jjsch-dev/filament_dryer_rp2040/README.md

# DIY Dehumidifier for 3D Printer Filaments
This project is a dehumidifier for 3D printer filaments that uses Arduino and Raspberry Pi modules. It heats and dries wet filaments to improve the quality and durability of your prints. It also has some cool features such as:

- A slow temperature ramp that prevents thermal shock and damage to the filaments.
- A heater temperature monitor that protects the equipment from overheating.
- A spool turn counter that tracks how much filament you have used or left.
- A PWM controller that turns on and off the heater based on the spool rotation speed.
- A PWM cut timer that stops the heater after a certain time period for safety reasons.
- A lid sensor that shuts off the heater when you open the lid to access the filaments.
- An auto-tuning algorithm that adjusts the PID constants for optimal temperature control.
- A USB interface that plots the graph of the system response and allows firmware updates.

The project uses a Raspberry Pi Pico instead of an Arduino Nano because it has more RAM and flash memory, which are needed for storing data and running complex algorithms.

I worked on the development of this project alongside with my friend [Manuel](https://www.printables.com/@ManuelM). He made the 3D model design of the enclosure and all its printable components. Plese use the following link [DIY Dehumidifier for 3D Printer Filaments](https://www.printables.com/model/494417-diy-dehumidifier-for-3d-printer-filaments) to get the step and the 3mf files.

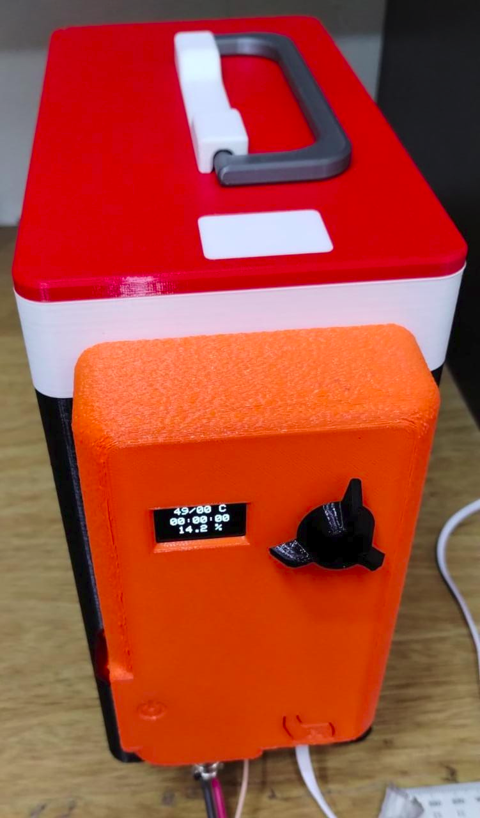
[picture p1: images/prototype-front.png]


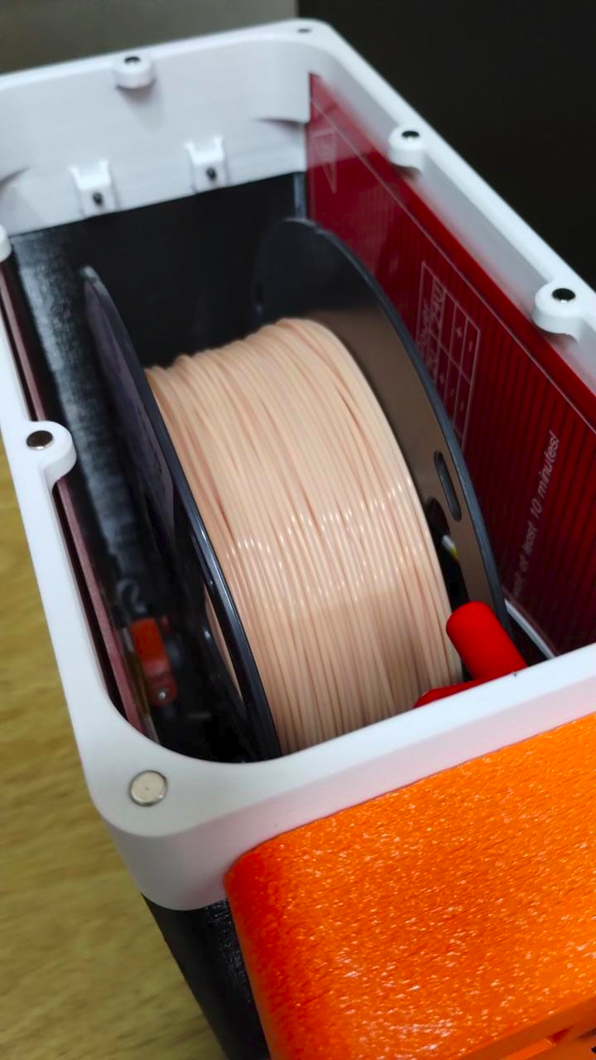
[picture p2: images/prototype-up.png]


Assembly Video
--------------
As the equipment has many parts, an assembly manual in this instance of the project becomes slow to produce, so we decided from Fusion 360 to generate a video where, in addition to seeing the dehumidifier explode, the assembly steps, screws and magnets are shown.

> All the magnets are placed under pressure (the holes have almost no play) and they must also be glued with cyanoacrylate so that the temperature does not loosen them.

> The cap handle and optical sensor bracket screws are parkers, the rest are M2x5 or M3x10/12.

https://user-images.githubusercontent.com/55675185/213236978-26854887-6648-46aa-a964-80c38ac183d2.mp4

Temperature control
-------------------
The temperature control module is based on the [QuickPID](https://github.com/Dlloydev/QuickPID) library which has an advanced anti-windup mode which prevents deep saturation and reduces overshoot.

The task of calculating the PID constants is based on the same author's [sTune](https://github.com/Dlloydev/sTune) library which uses an open-loop PID auto-tuner using a novel s-curve kneepoint test method.

Measurement of the humidity and temperature of the box
------------------------------------------------------
The equipment uses the [SHT21](https://sensirion.com/products/catalog/SHT21/) sensor from Sensirion to measure the humidity and temperature of the box. This sensor can be purchased as a mounted module from [Adafruit](https://www.adafruit.com/product/1899) or other suppliers. To read the data from the sensor, the [HTU21D](https://github.com/devxplained/HTU21D-Sensor-Library) library is used through the I2C port.

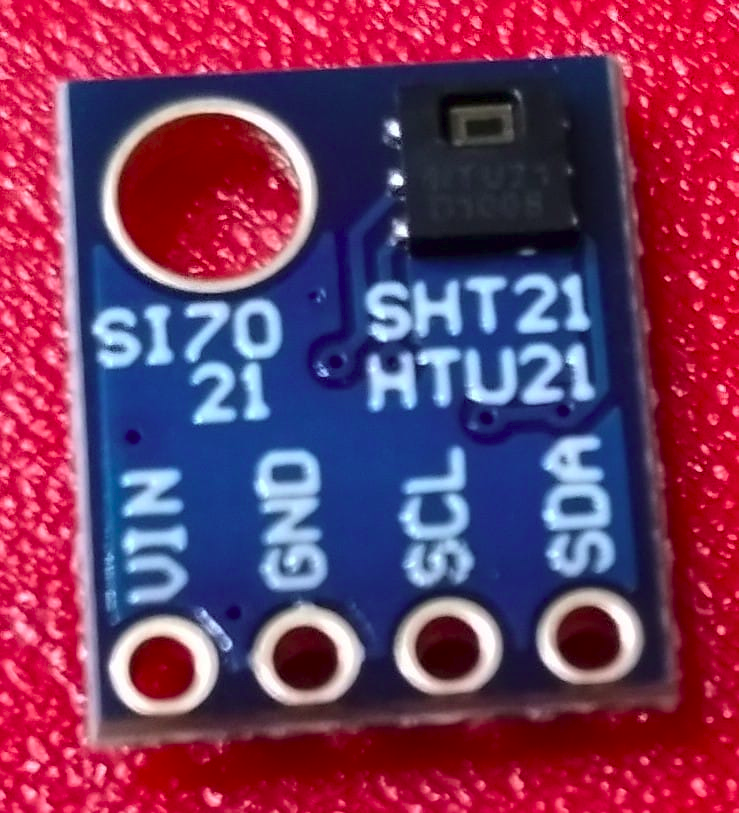
[picture p3: images/temp_humidity_sensor.png]


Thermistors for Over Temperature Protection
-------------------------------------------
The heaters can reach very high temperatures that can damage the system or cause a fire. As the box is printed in Petg a protection system was implemented that turns off the heaters when a temperature above a 80 degrees is detected. The system uses two thermistors of [100 KHOM at 25ºC and a B of 3950K ±1%](https://a.aliexpress.com/_m0eyg30) to measure the temperature of each heater. 
Thermistors are resistive sensors that vary their value according to temperature. However, due to the deviation of the associated hardware (4k7 resistance and reference voltage of the analog-digital converter), it is necessary to calibrate the thermistors to improve their accuracy. The calibration is done using as reference the temperature of the SHT21 sensor that measures the temperature of the thermal box and has an accuracy of 0.5%. The calibration consists of calculating a factor that is applied to the [thermistor](https://github.com/miguel5612/ThermistorLibrary) library readings to correct their value. This factor is stored in the Arduino’s EEPROM memory for use in future measurements. The calibration can be done from the Calib menu on the LCD when temperatures are stabilized.

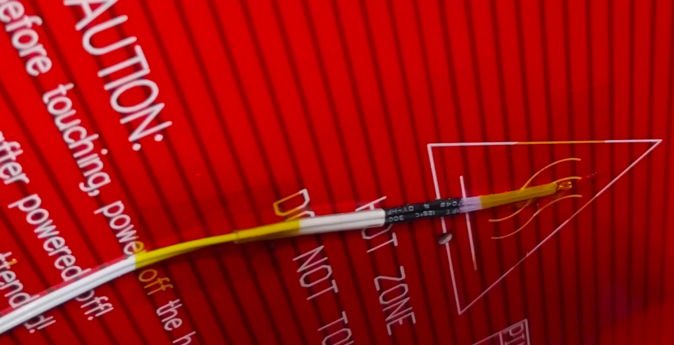
[picture p4: images/thermistor_mounted.png]


Since there is no Arduino module for the thermistors, the divider resistor and filter capacitor are installed on the berry pico board as shown in the picture.

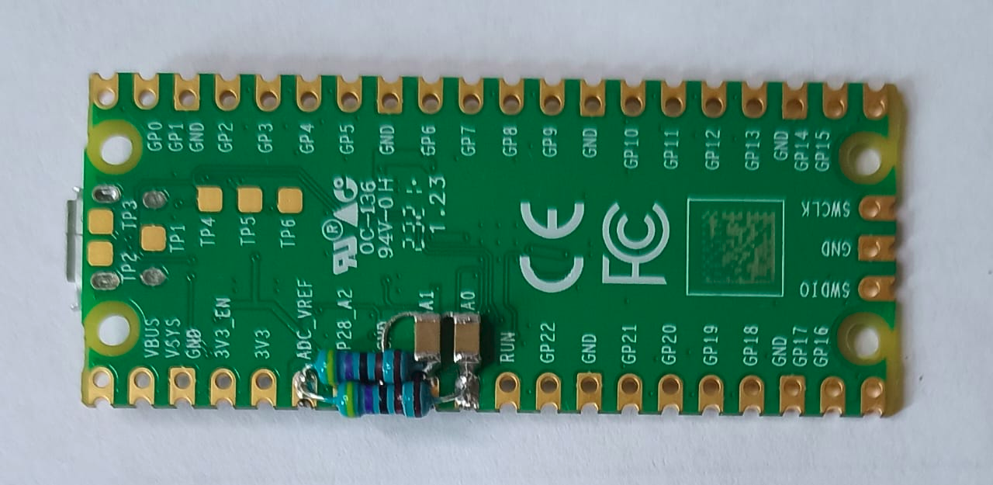
[picture p5: images/thermistor_berry.png]


> Note: For now the thermistor library does not include the pull request that adds compatibility with arduinopico, so use this [link](https://github.com/jjsch-dev/ThermistorLibrary) to download the modified one.

User Interfase
--------------
The user interface is based on a 0.96-inch OLED screen that displays text and uses the [Adafruit_SSD1306](https://github.com/adafruit/Adafruit_SSD1306) library through an I2C interface.

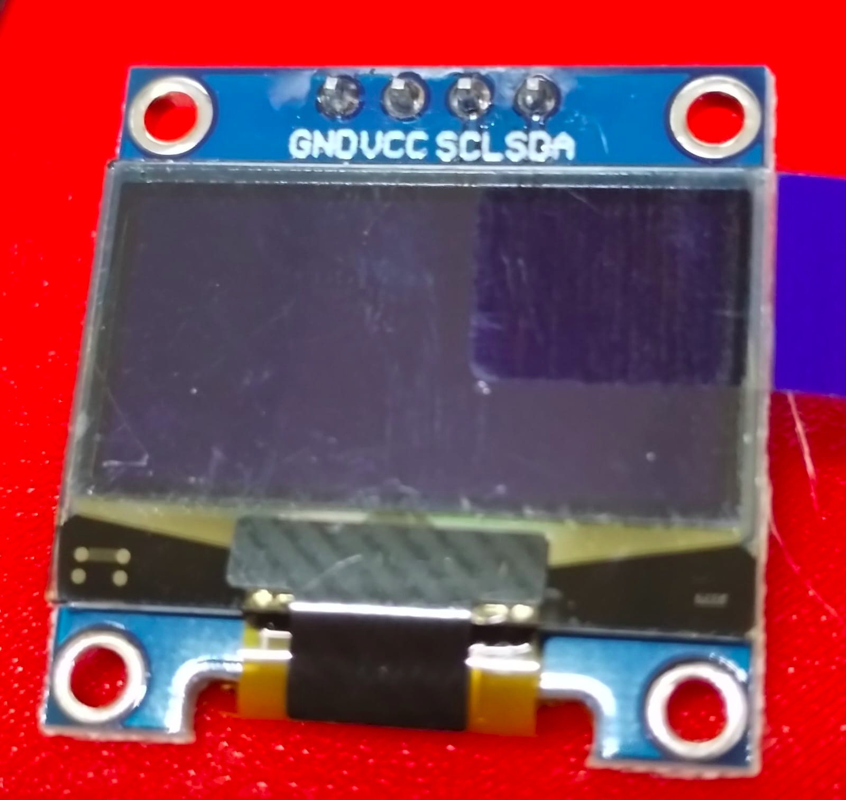
[picture p6: images/oled_display.png]


For user input, we use a rotary encoder and the [EncoderButton](https://github.com/Stutchbury/EncoderButton) library, which depends on the [Encoder Library](https://www.pjrc.com/teensy/td_libs_Encoder.html) and the [EncoderLibrary Bounce2](https://github.com/thomasfredericks/Bounce2) libraries.

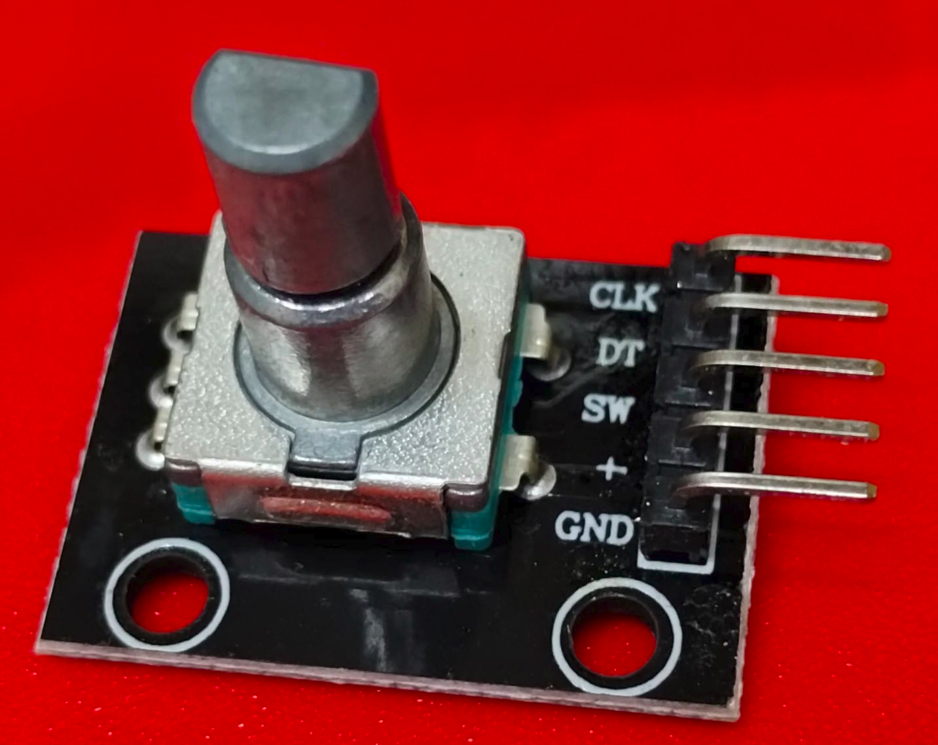
[picture p7: images/rotary_encoder.png]


> Note: For now the Encoder library does not include the pull request that adds compatibility with arduinopico, so use this [link](https://github.com/jjsch-dev/Encoder) to download the modified one.

Heater
------
To heat the box, two 3D printer beds are used as heating elements.

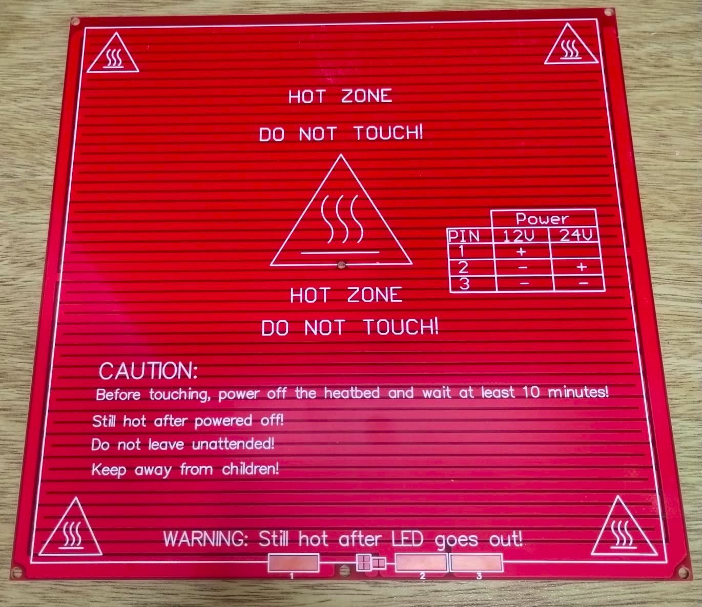
[picture p8: images/heat_bed.png]


And two [15A mofsets](https://a.aliexpress.com/_mNwI6G6) that regulate the power with PWM channels.

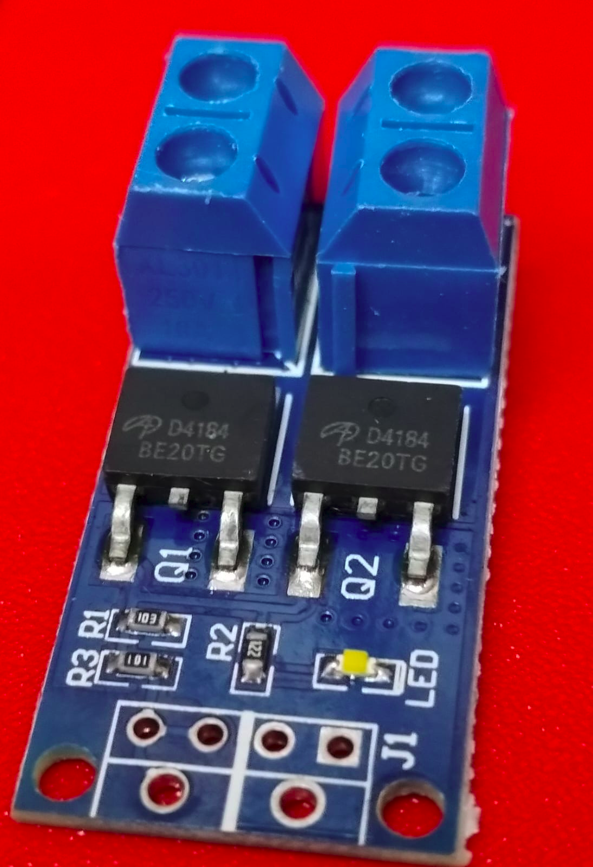
[picture p9: images/mosfet.png]


To homogenize the environment of the box, a [4010 fan cooler](https://a.aliexpress.com/_ms9WyQe) is used that for now turns on at 100%.

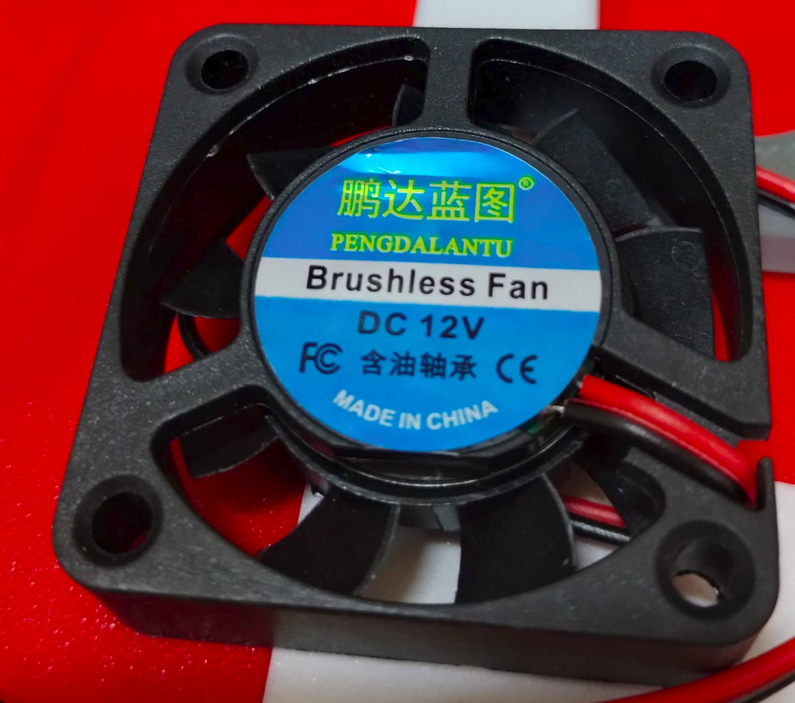
[picture p10: images/fan_cooler.png]


Moisture Ventilation
--------------------
So that the moisture from the filament that evaporates when heating the box goes outside, a ventilation valve is incorporated that is activated by an [Servo SG92](https://www.adafruit.com/product/169).

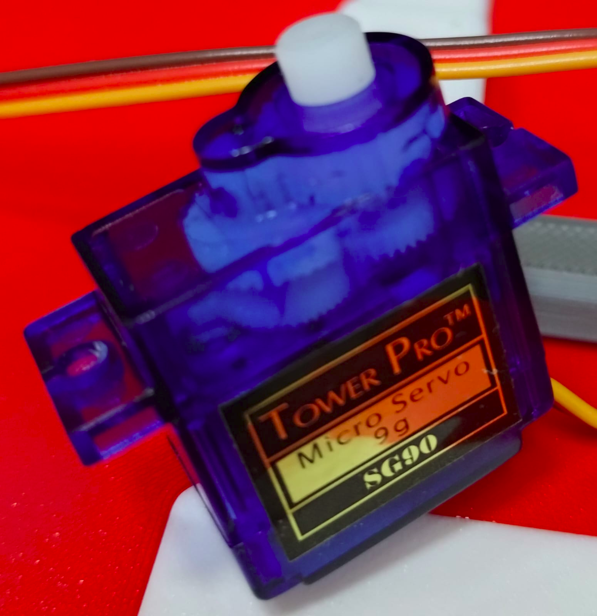
[picture p11: images/servo.png]


To control it, the internal [Servo](https://github.com/earlephilhower/arduino-pico/tree/master/libraries/Servo) library of the arduinopico porting is used, which is based on the PIO of the Rasperry Pi Pico RP2040.

- The valve is made up of three parts: a rectangular hole in the box cover with a 45-degree chamfer to increase the contact surface, the valve that has a 0.2 mm offset, and a post that, in addition to being the stop, supports the magnet that brings the door to the closed position. To fasten it, two M2 * 5 screws are used.

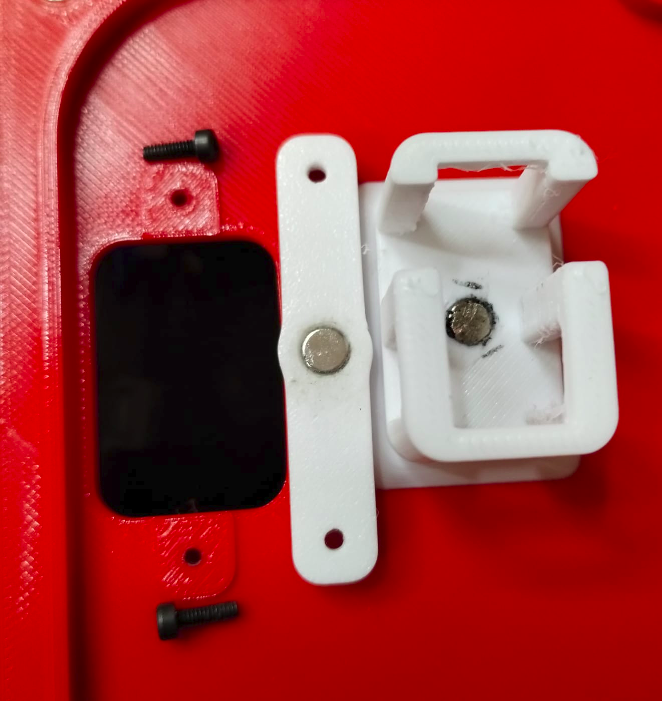
[picture p12: images/valve_parts.png]


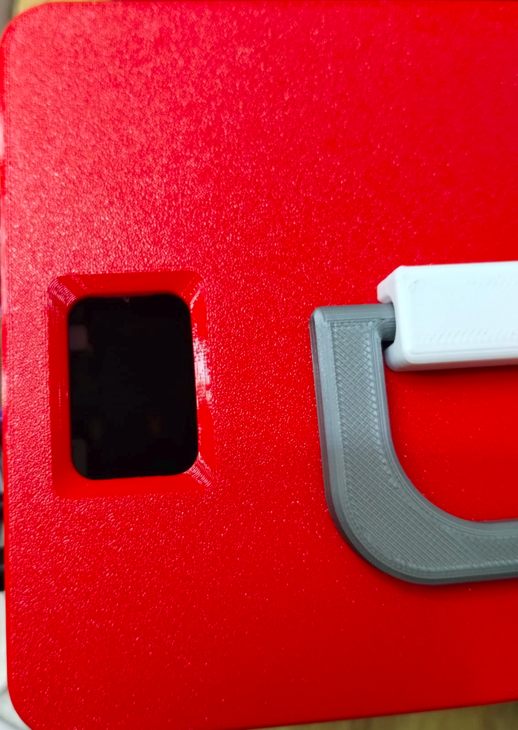
[picture p13: images/valve_cap.png]


- When the servo arm moves down and stops pushing on the valve, the magnets attract each other and create a force of approximately 300 grams to close the vent.

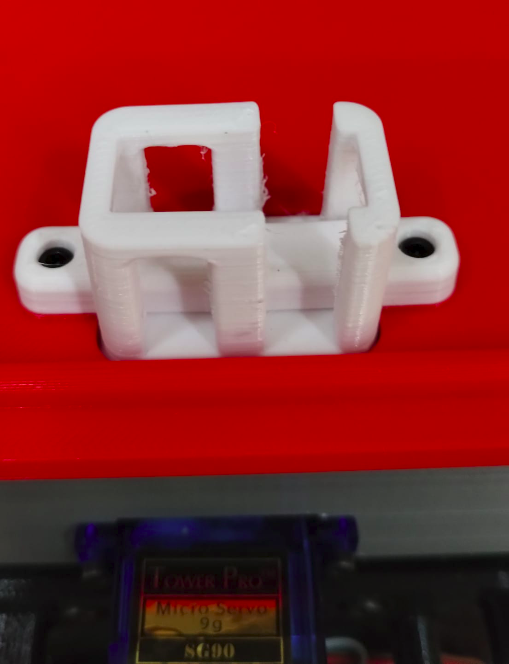
[picture p14: images/valve_close.png]


- To open the valve, the servo moves the arm approximately 45 degrees, it should be noted that the servo makes the most effort at the beginning, and the plastic gear version can make a torque of 1.5 kg per centimeter.

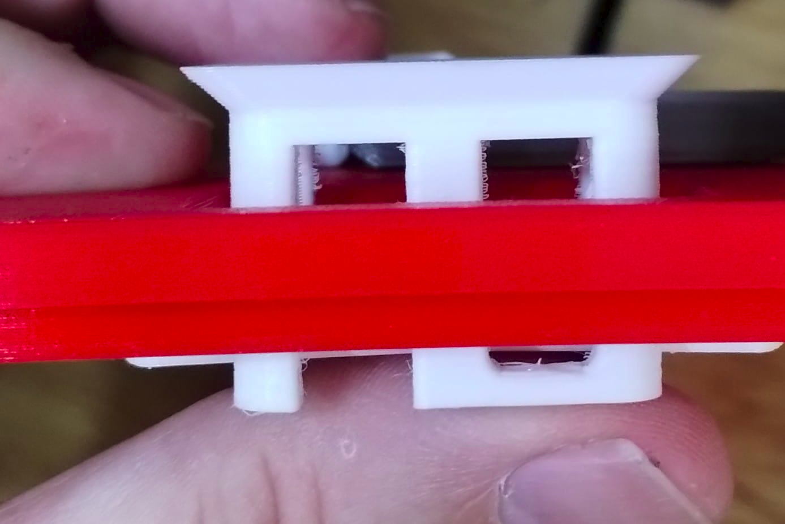
[picture p15: images/valve_open.png]


- The servo arm is a combined part between 3D printing and injection that is sold with the kit. This is because in addition to the fact that the shaft rack is difficult to print, heat easily warps common printed plastics.

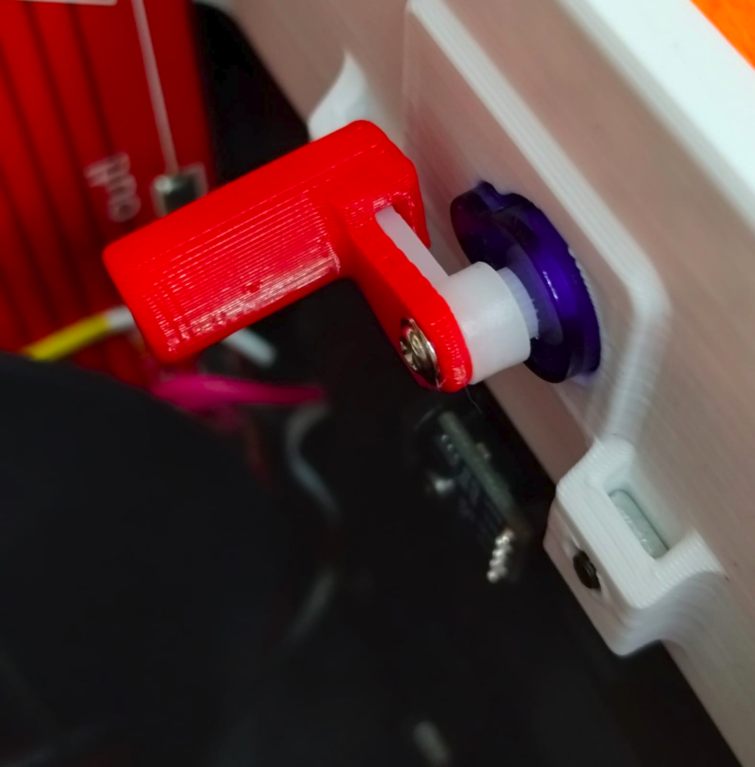
[picture p16: images/valve_servo.png]


Door lid sensor
---------------
The door lid sensor is a mechanical switch with an anti-bounce circuit that detects if the lid of the heater is open or closed. The switch is connected to GP22 of the digital pins of the Arduino board and reads either HIGH or LOW depending on the state of the lid.

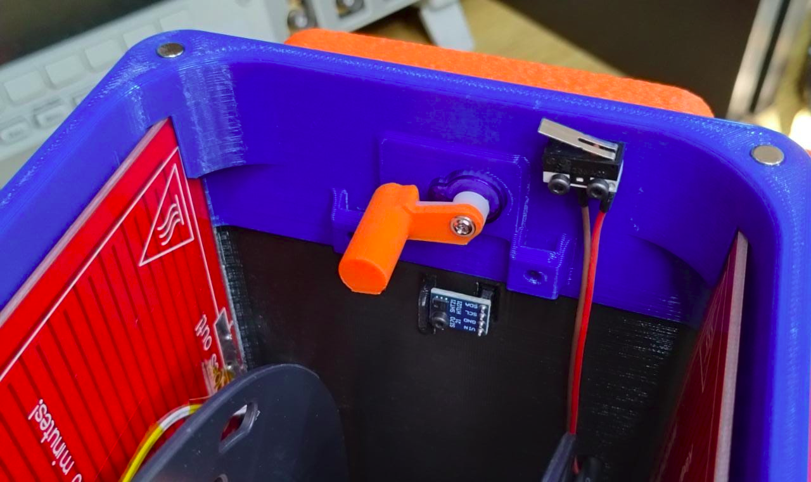
[picture p17: images/door_lid_sensor.png]


If the lid is open, the Arduino displays a message on the LCD screen saying “Open Lid” and turns off the heater by setting the output pin of the mofset to LOW. This prevents overheating and potential fire hazards.

If the lid is closed, the Arduino waits for a signal from the operator or the start system that detects the reel’s rotation to resume operation and control the heater using a PID algorithm based on the readings from the temperature and humidity sensor.

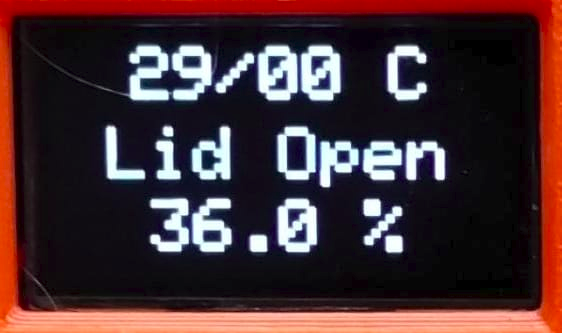
[picture p18: images/door_lid_open.png]


Install the arm on the servo
----------------------------

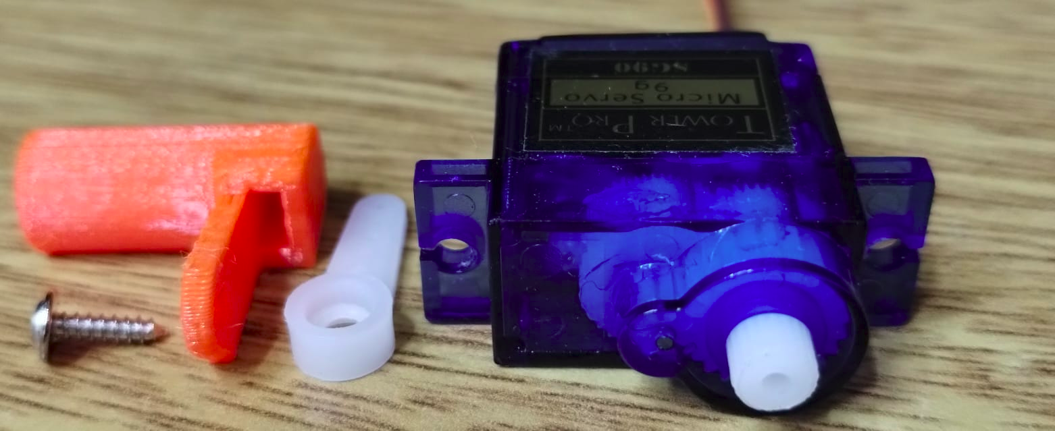
[picture p19: images/arm_servo_parts.png]


- Once the electronics of the equipment have been assembled and the firmware downloaded, connect it to the USB and select turn off the equipment in the menu so that the servo turns to the closed position.

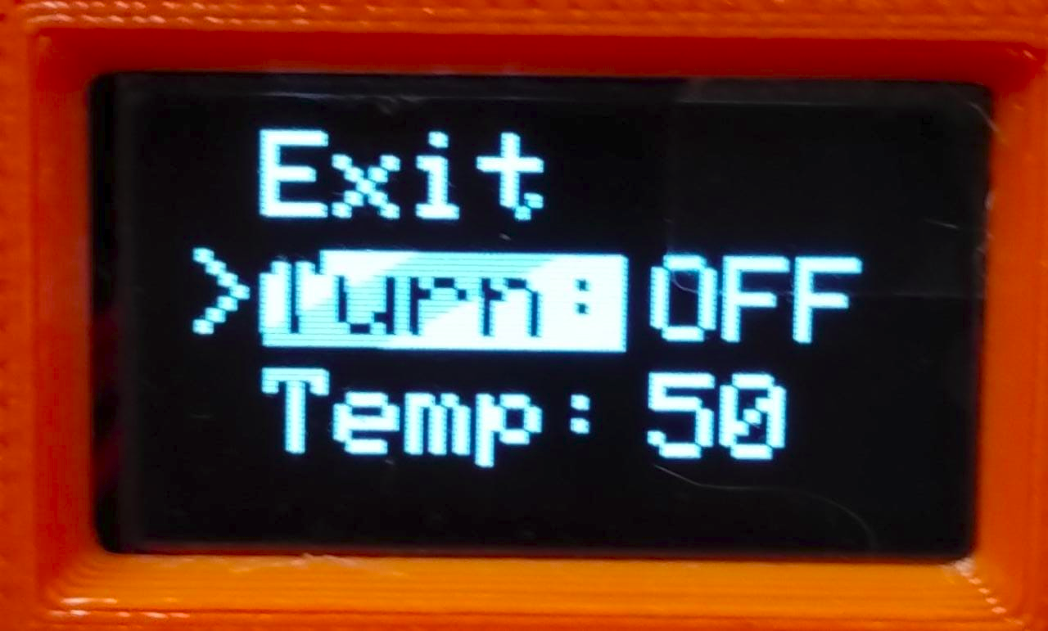
[picture p20: images/arm_servo_off.png]


- Insert the lever that comes with the servo kit more or less at 95° with respect to the vertical of the drawer as shown in the figure. 

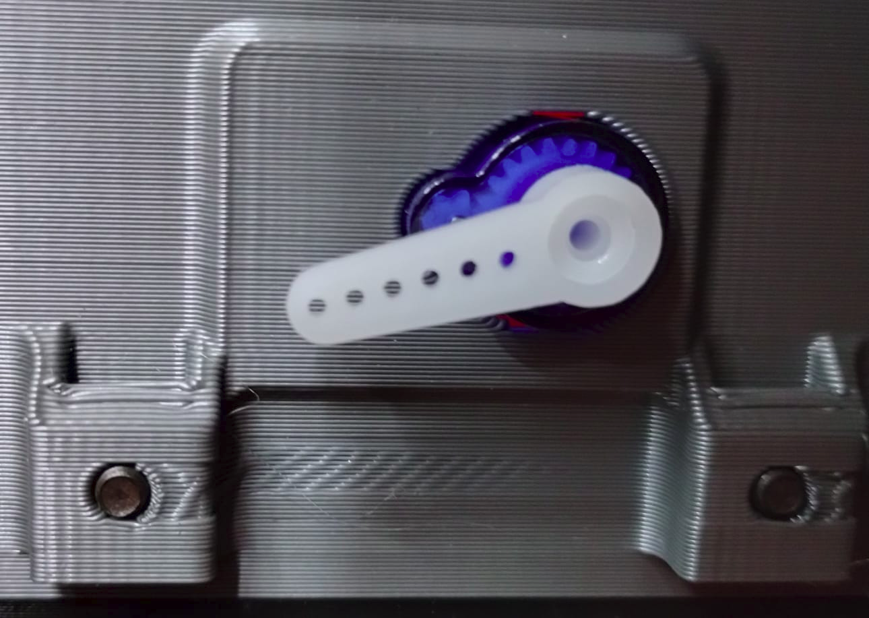
[picture p21: images/arm_servo_abs.png]


- Insert the PETG printed lever and use the long screw that comes with the kit to attach the parts to the servo shaft.

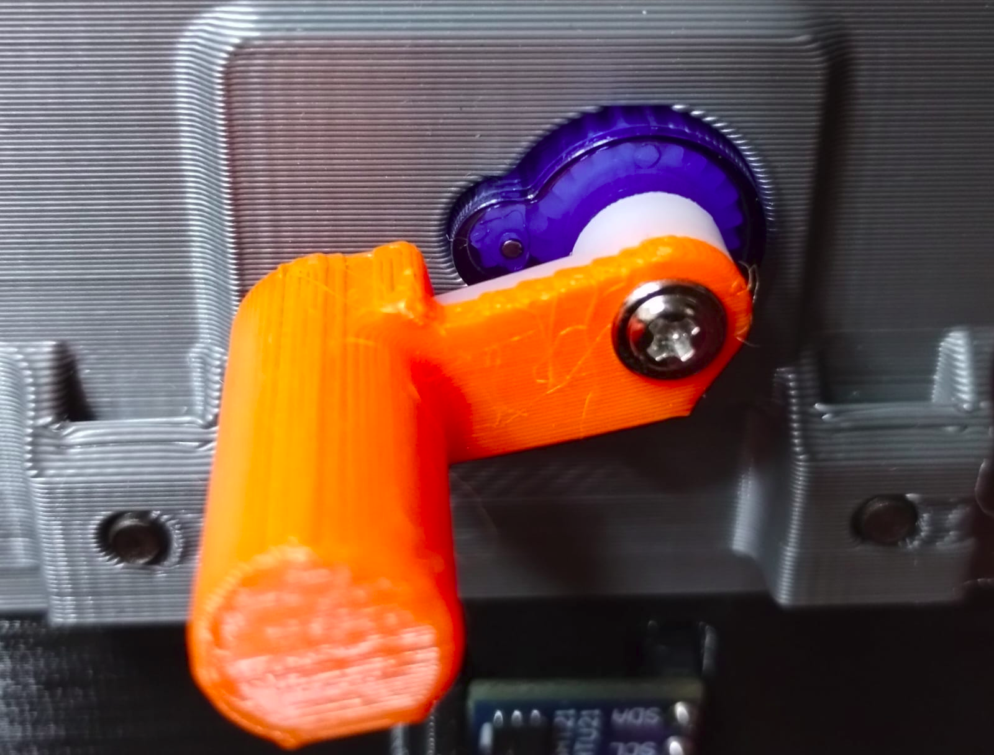
[picture p22: images/arm_servo_close.png]


- Go to the menu and turn on the equipment.

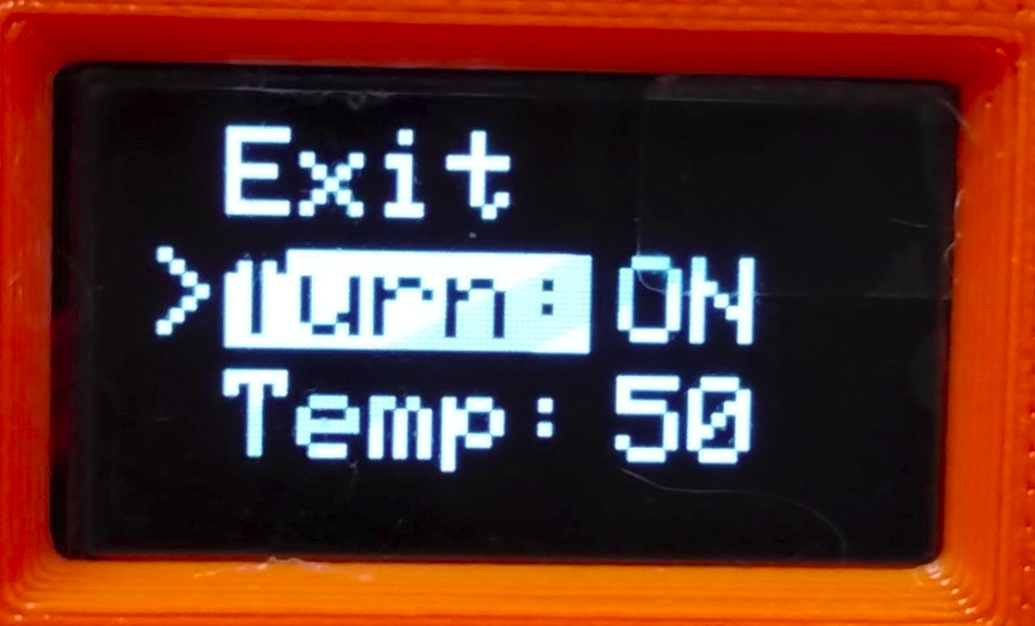
[picture p23: images/arm_servo_on.png]


- The arm should go up as the image shows.

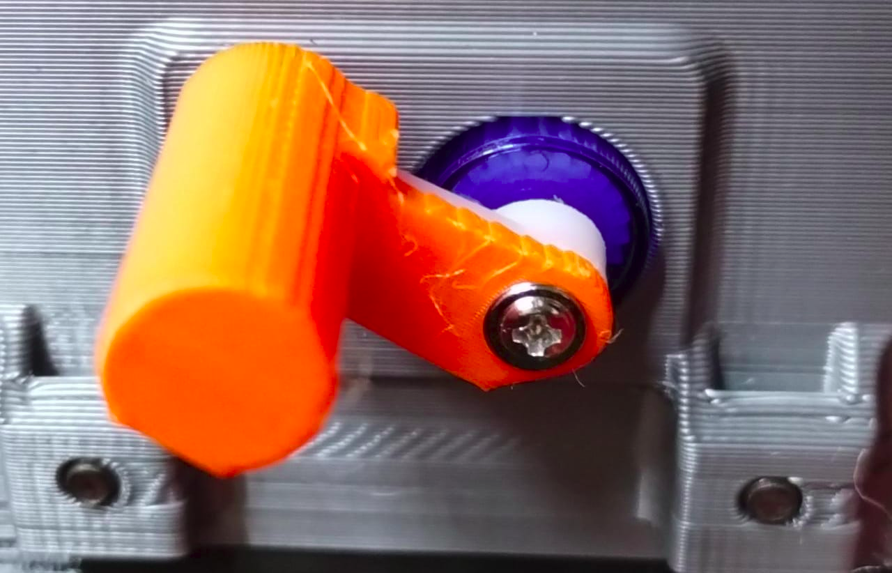
[picture p24: images/arm_servo_open.png]


- To adjust the positions use the menu (close/open) to modify the opening and closing angles, pay special attention that in the **open** position the valve has play and does not touch the magnet post, and in the **close** position it does not touch the valve so the servo doesn't jam hard and get hot. 

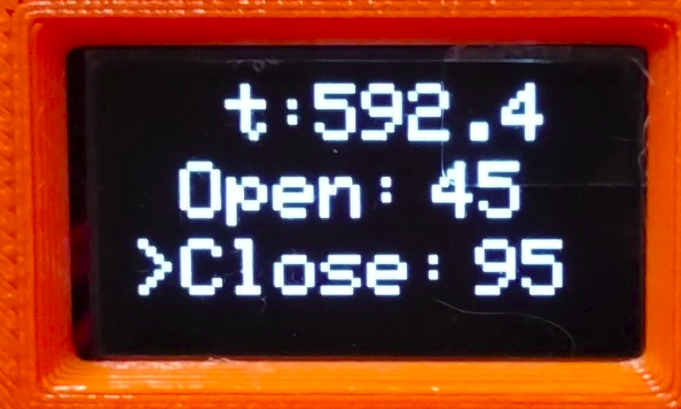
[picture p25: images/arm_servo_adjust.png]


Odometer
--------
One of the axes where the filament spool rests has a 6-position encoder so that an optical [Sensor TCRT5000 Infrared Reflection](https://www.aliexpress.com/i/1005004306354385.html) detects its movement.

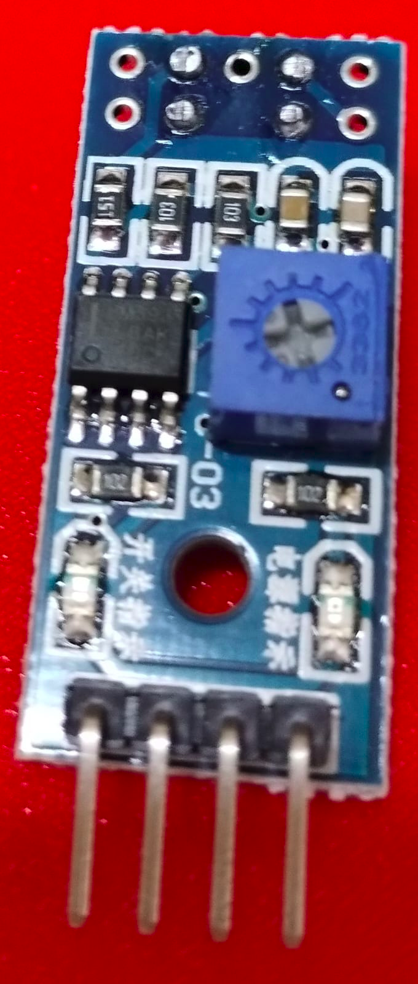
[picture p26: images/optical_sensor_back.png]


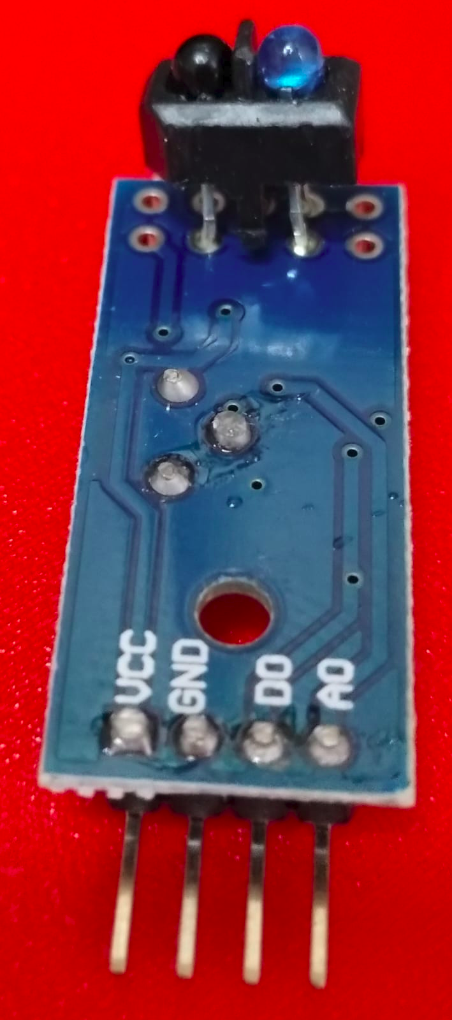
[picture p27: images/optical_sensor_front.png]


One of the functions is to turn on the equipment when it detects that the reel has started to rotate and also to turn off the equipment when it no longer rotates in a certain time.

It also counts the number of turns that the spool has given since the last reset, transforming the pulses into turns by setting the diameter of the spool.

Spool rollers
-------------
The rollers where the spool rests are made up of two parts: a threaded bar M8 * 95mm that gives resistance to deformation by temperature and an ABS cover that positions them. In order for the spool to rotate as smoothly as possible, the axis is supported by two 608 ZZ bearings.

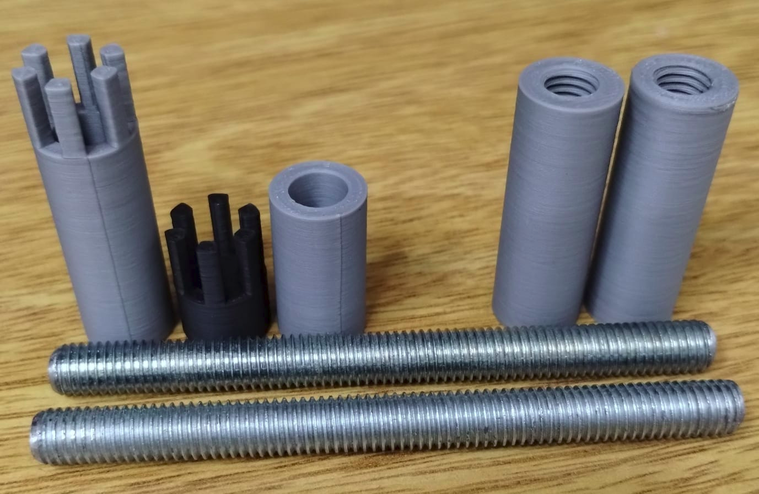
[picture p28: images/spool_rollers_parts.png]


The two ABS covers are different: the used for the optical encoder has three parts, two of a light color (silver or white) and one in black so that the contrast is as high as possible. The second cover is formed by two equal pieces and the color is indistinct.

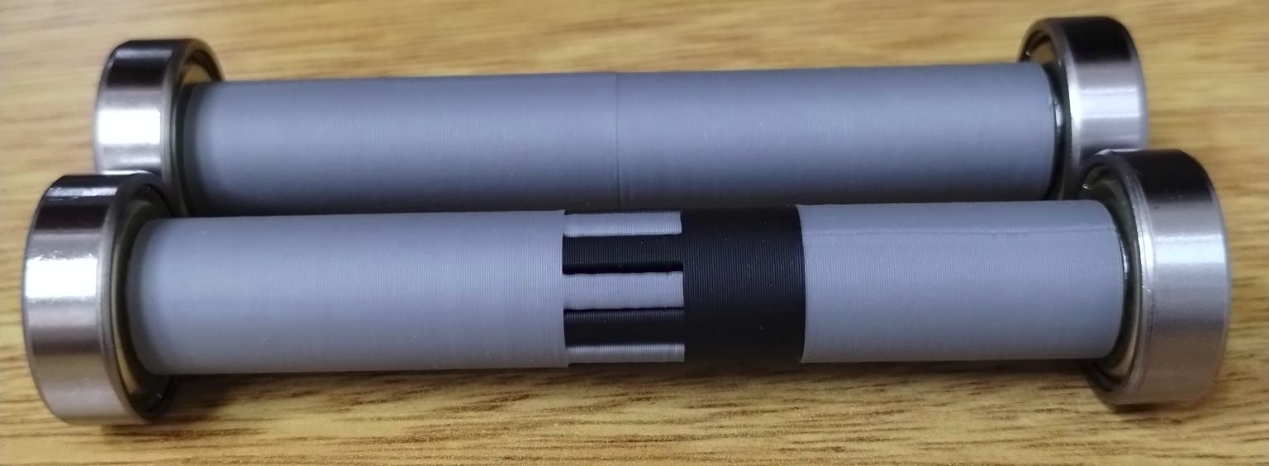
[picture p29: images/spool_rollers_assembly.png]


>The ABS covers are threaded so that they are taut when adjusted.

Odometer sensitivity adjustment
-------------------------------
In order for the TTL output (D0) of the odometer sensor to change when the roller is moved (from white to black and vice versa), the comparator sensitivity must be adjusted with the potentiometer.

- Use an allen key to unscrew the cap on the back of the box and insert a screwdriver until it contacts the potentiometer.

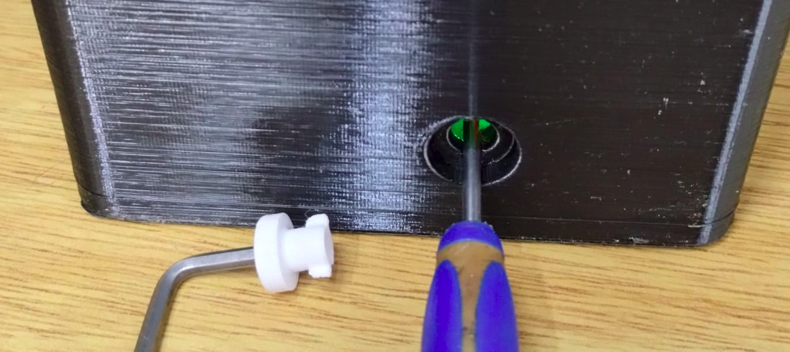
[picture p30: images/unscrew_odometer_cap.png]


- Turn the potentiometer until the sensor status indicator turns off.

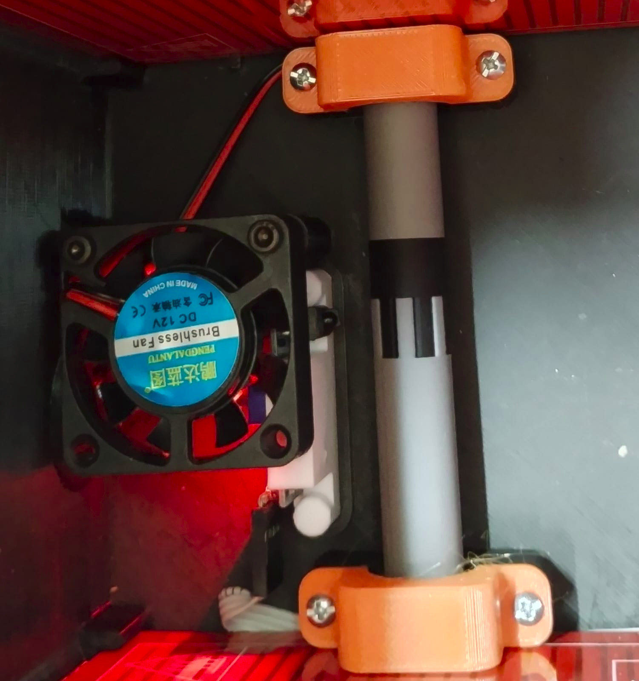
[picture p31: images/odometer_sensor_off.png]


- Rotate the roller by hand until it turns back on, repeat this operation until you are sure the sensor detects transitions from white to black.

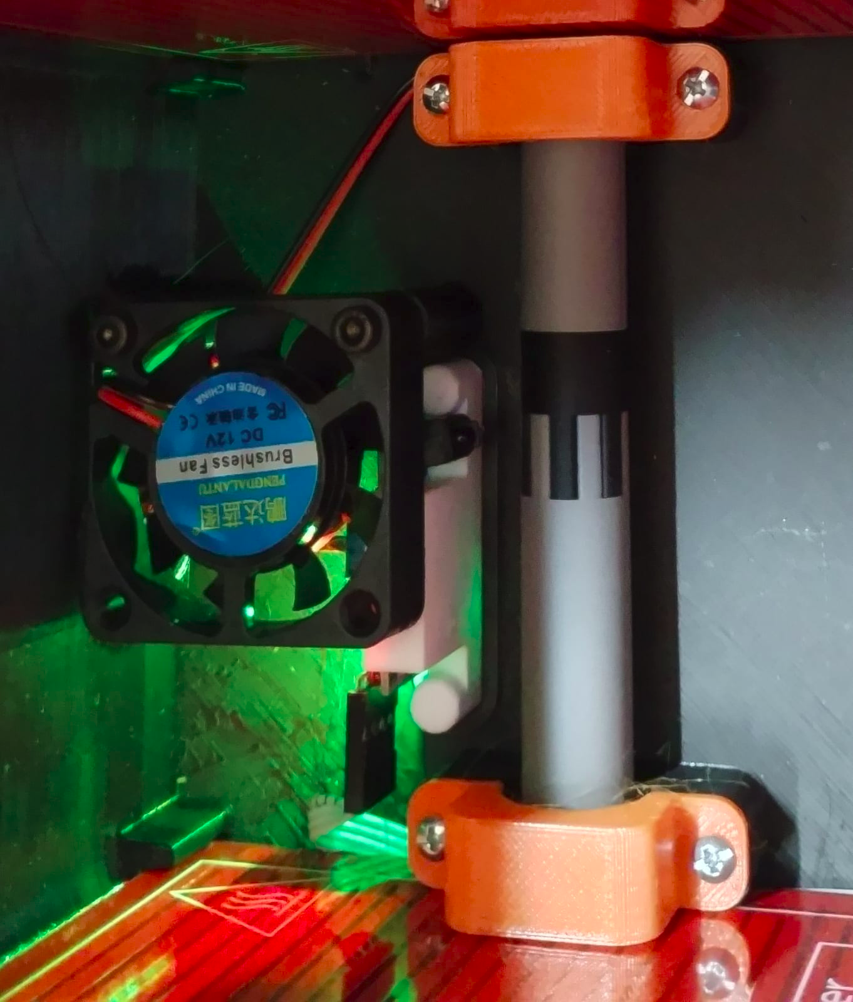
[picture p32: images/odometer_sensor_on.png]


Go to the setup menu to verify that the turns counter (t) increases as the reel rotates.

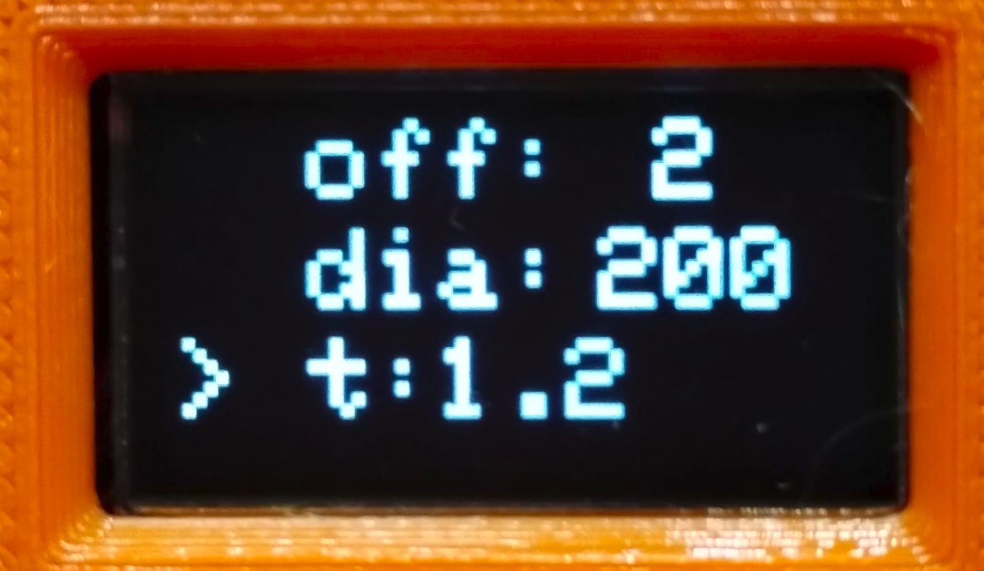
[picture p33: images/odometer_turns.png]


Menu
----
The configuration menu maintains a simplified operation from the time when the Arduino Nano was used, which has little RAM and FLASH memory, this is not the case with the Berry.

When the device is in information mode, it displays three lines of data. 

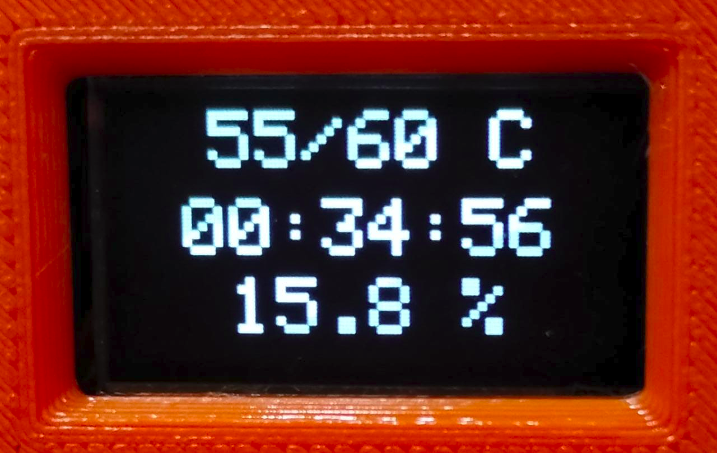
[picture p34: images/display_info.png]


- The first on the left shows the current temperature of the box and on the right the set one (0 = device off).
- The second line shows the remaining operating time.
- The third is the relative humidity of the box.

To enter the configuration menu you have to press the encoder.

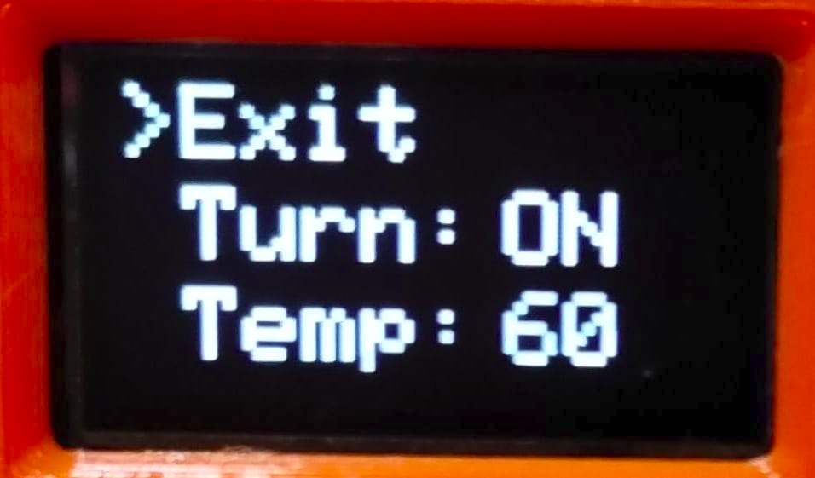
[picture p35: images/display_enter_cfg.png]


Using the rotary encoder you can explore all the menu items, and when you need to modify a value, you have to press the encoder button, if it is editable the item is marked by inverting the colors.

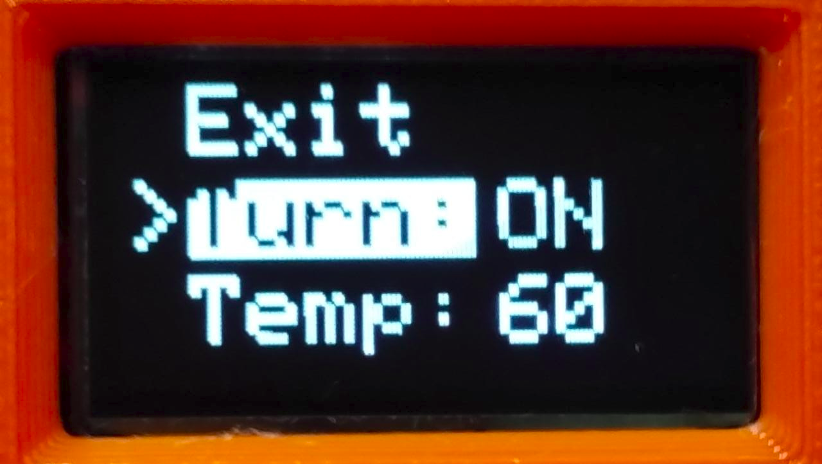
[picture p36: images/display_item_edit.png]


Use the rotary encoder to modify the value of the element, which can be numeric or a list of options. When the rotary encoder button is pressed, in addition to saving the value in the eeprom memory, editing ends.

## Menu List
- **Exit** press the button to exit the menu.
- **Turn** turns the temperature control on/off. 
- **Temp** select the temperature of the box, the range is from 40 to 60 ° Celcius. 0 = disabled.
- **Time** select temperature control run time in hours, range is from 1 to 72 hours. 0 = disabled.
- **Tune** On to allow the device to calculate the PID constants and save them to the eeprom. It is advisable to do it with a full spool and starting from room temperature.
- **Therm**  select the number of thermistors that sense the temperature of the heater to prevent it from melting the bed supports (80°Celsius). At least one is recommended.
  - **cali** calibrate the thermistors to improve their accuracy. It is important to calibrate them when temperatures are stabilized (12 hs OFF) to get better results. 
- **Heat** displays the temperature of the heating element. Use the thermistor that is hotter.
- **Odom** activates the functions of turning on (Start) the heating element when the reel rotates, or turning off (Stop) when it has stopped for a while. (Both) activates both functions.
  - **off** time in minutes that it waits to turn off the heater when the spool stops spinning. 
  - **dia** diameter in millimeters of the spool to convert pulses to turns.
  - **t** number of turns that the reel has given since the last reset of the counter. Move the encoder to the left to reset it.
- **Open** position in degrees of the servo when the vent door is open. Typically 90 degrees.
- **Close** position in degrees of the servo when the vent door is closed. Typically 43 degrees.
- **Kp** proportional constant of the PID controller.
- **Ki** integrative constant of the PID controller.
- **Kd** derivative constant of the PID controller.
- **Frst** On to restore all parameters to factory.
- **V** firmware version. 

Schematic
---------
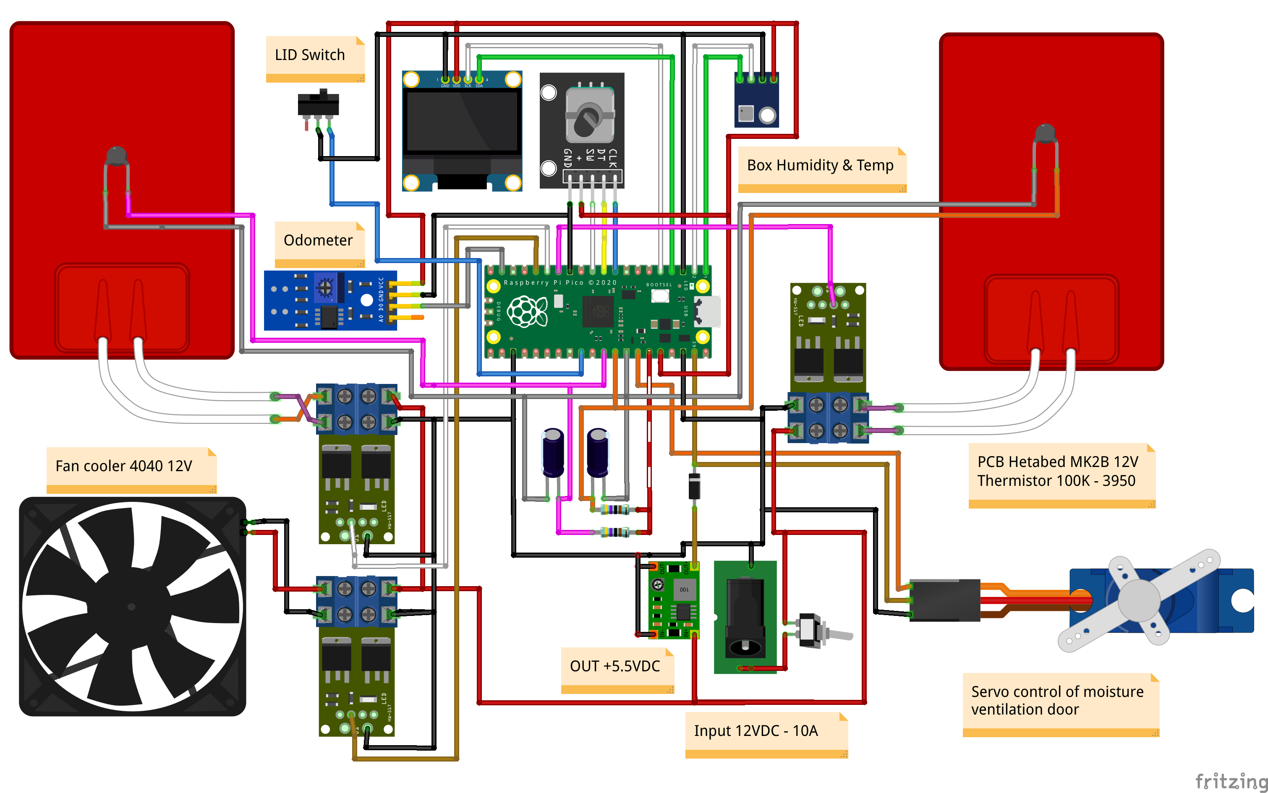
[picture p37: images/filament_dryer_bb.png]


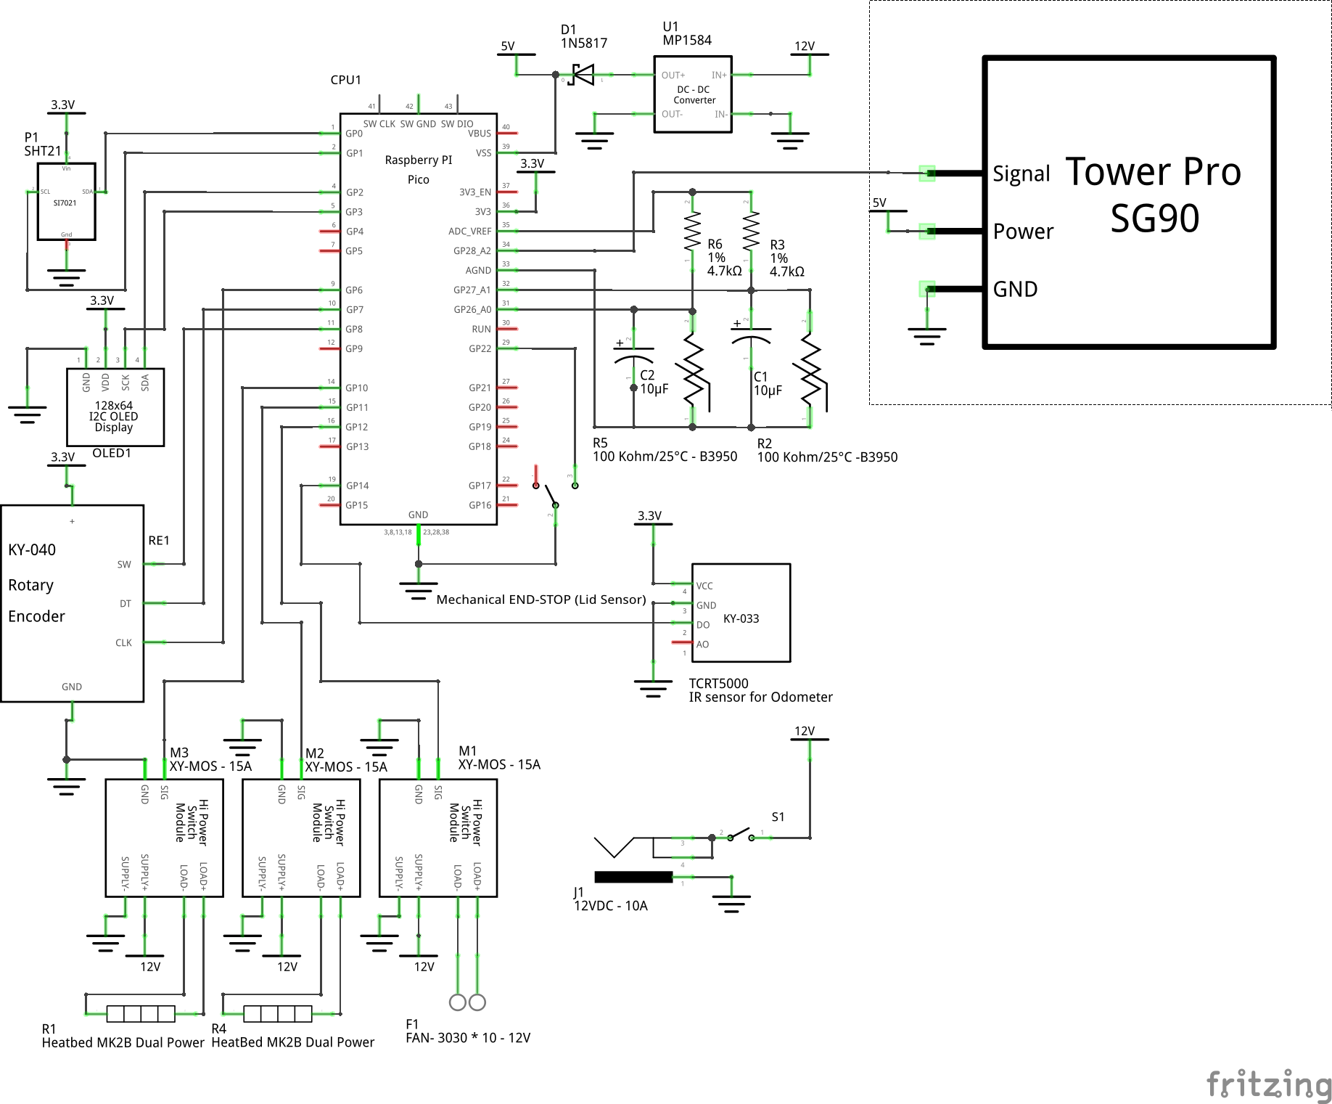
[picture p38: images/filament_dryer_schem.png]


Assembly of electronics version one
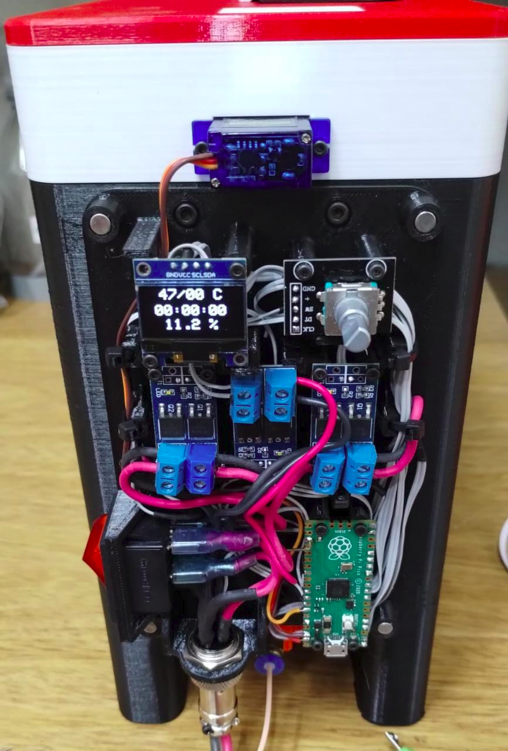
[picture p39: images/prototype-electronic.png]


Assembly of electronics version two
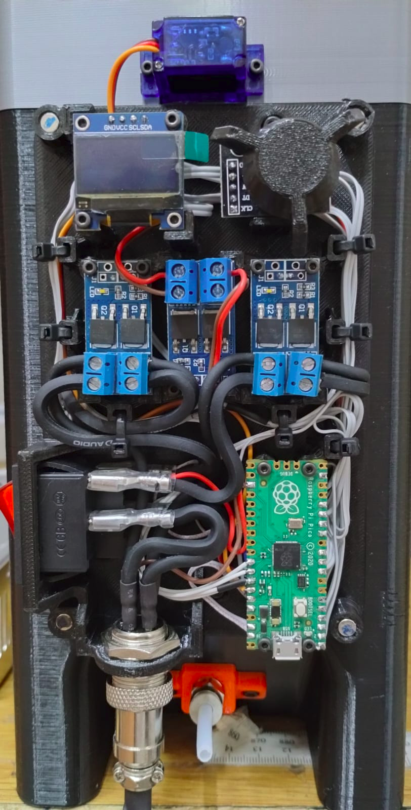
[picture p40: images/prototype-electronic_v2.png]


A Guide to PID and Auto Tune for Temperature Regulation
-------------------------------------------------------
The auto tune is a process that adjusts the PID constants to optimize the performance of the equipment.

By default, the equipment has some PID constants that allow it to operate, but they are not optimal as they depend on several factors such as:

- The power supply voltage
- The resistance of the electrical wires
- The impedance of the heater
- The air flow that moves the fan

Therefore, it is necessary to run the auto tune menu at least once. To do it correctly, the following conditions must be met:

- The equipment has not been used for a long time and both temperature sensors (box and heater) are equal to room temperature

- A full filament spool is used because it modifies the air flow

When running the auto tune, it is expected that the system reaches a stable temperature without oscillations or overheating. Below is a graph with an un-tuned system. It can be seen that the it tends to rise very fast in temperature and exceed 80°C when removing box lid. On other hand, synchronized system maintains a more constant and controlled temperature.

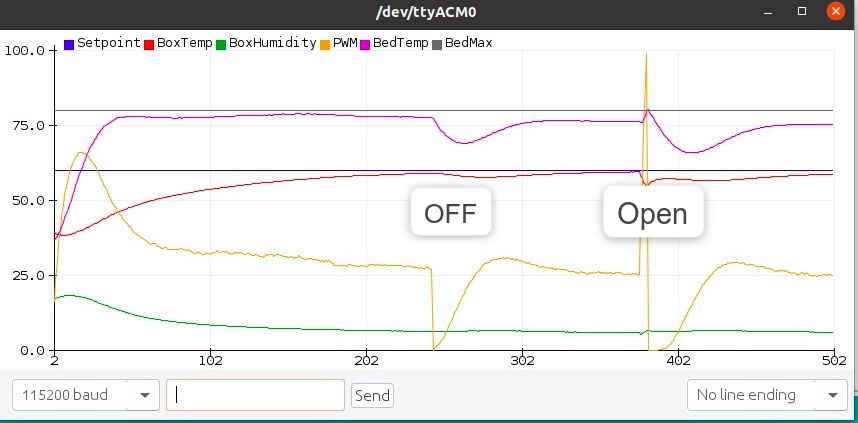
[picture p41: images/plot_tune_off_open.png]


> Note: **Off** and **Open** in the graph refer to whether the user turned off the device or removed the lid of the box, respectively.

Power Supply
------------
The main power supply is 12V 20A, which is responsible for powering the heaters, the fan, and through a swicthing step-down supplying the 5V to the Berry Pico, which in turn uses the internal 3.3V regulator to power the CPU and the rest of the electronics.

The 5V step-down is connected to the berry pico with a shotcky diode so that the board can be simultaneously connected to a PC's USB, for example, to get system response via a serial port.

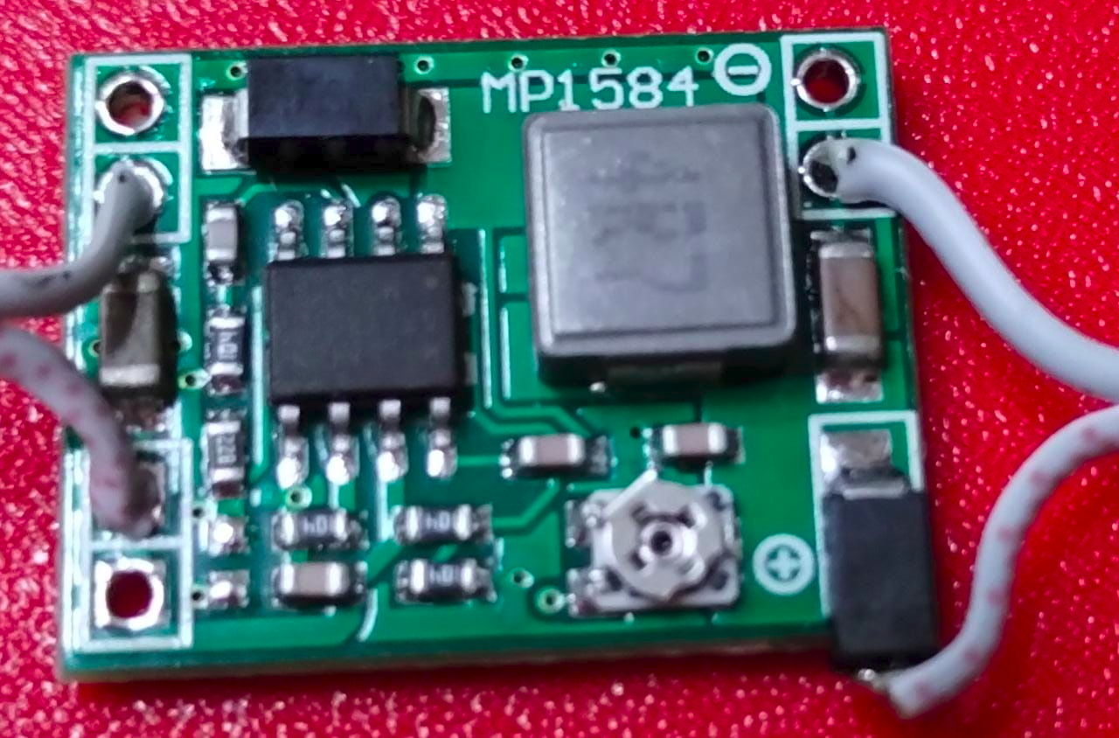
[picture p42: images/power_supply_5v.png]


> Before installing the 5V supply, set the output voltage to 5.5V to compensate for diode drop.

The thermistors are connected to the ADC_REF so that the end of the positive resistive divider matches the reference of the analog-to-digital converter.

To connect the power supply to the equipment, it is recommended to use a 1.5 mm (16AWG) section cable to avoid falls, in this case we use a 70-thread [speaker cable](https://stingerelectronics.com/products/16ga-speaker-wire-white-500-roll). The length should not exceed 2 meters.

If the output voltage can be adjusted, regulate it to 12.5V to compensate for the losses in the connection cable and in the power switch.

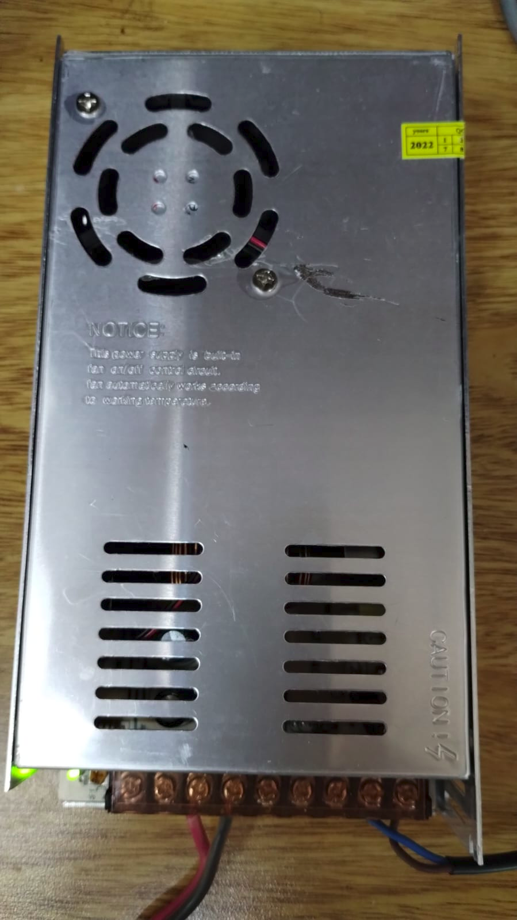
[picture p43: images/power_supply.png]


Power Switch and Connector
--------------------------
In order for the wiring to support the power consumed by the equipment, a [KCD4 ROCKER SWITCH ON OFF DPST 4 PIN](https://a.aliexpress.com/_mMvt3Wa) and a [4-pin GX Aviation Connector](https://renhotecpro.com/product/gx16-butt-joint-straight-connector-metal-shell) were chosen, to divide into two 10A maximum circuits (one for each heater).

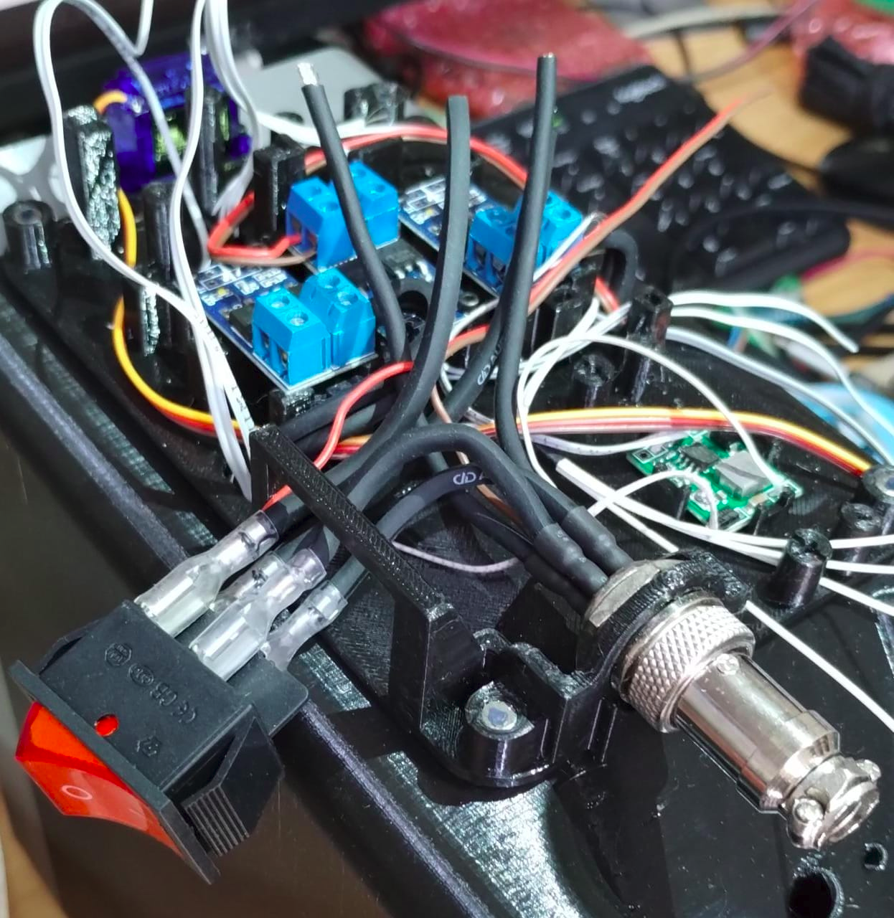
[picture p44: images/power_switch.png]


Download the firmware in Raspberry Pi Pico
------------------------------------------
Hold down the BOOTSEL button while plugging the board into USB. The uf2 file [filament_dryer_rp2040.ino.uf2](https://github.com/jjsch-dev/filament_dryer_rp2040/tree/master/bin/filament_dryer_rp2040.ino.uf2) should then be copied to the USB mass storage device that appears. Once programming of the new firmware is complete the device will automatically reset and be ready for use.

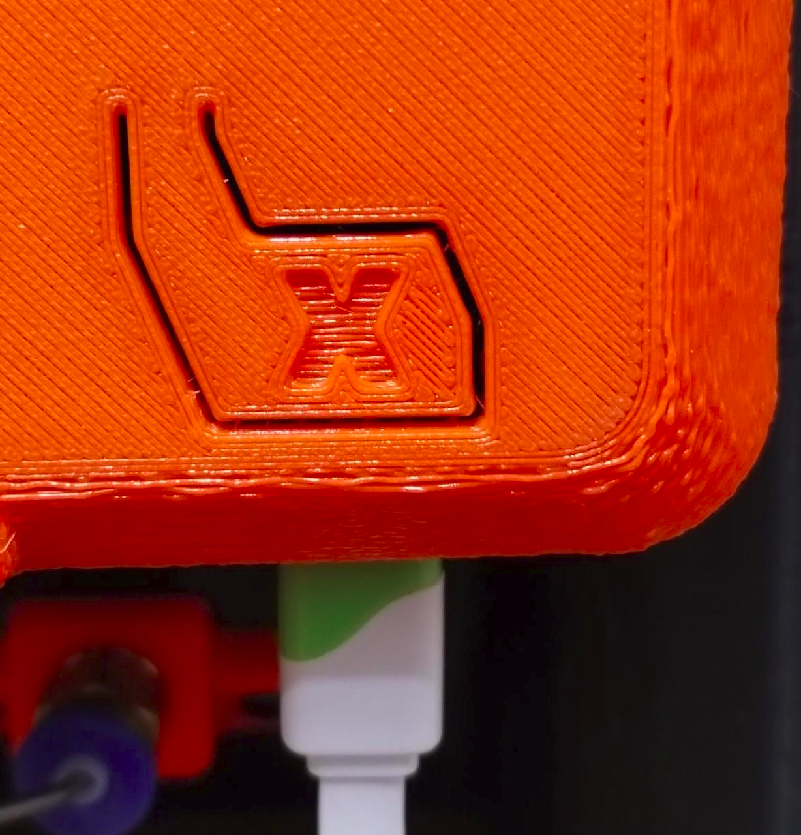
[picture p45: images/boot_sel.png]


System Response
---------------
The device can plot the system response over USB using the Arduino serial plotter.

The curves below show how humidity drops as time goes by and the temperature rises.

## Reference
- **SetPoint** selected temperature for the box (40 to 60° Celsius).
- **BoxTemp** box temperature.
- **BoxHumidity** relative humidity of the box.
- **PWM** power of the heaters (0 to 100%).
- **BedMax** maximum temperature that heater can reach (80° Celsius).
- **BedTemp** heaters temperature.

60 degree graph
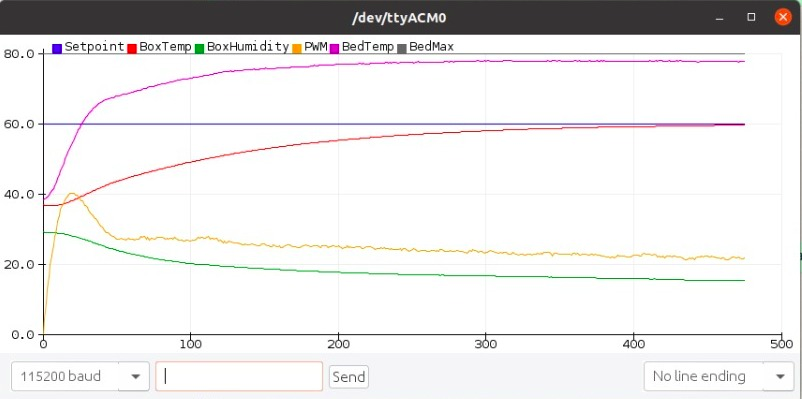
[picture p46: images/plot_60.png]


55 degree graph
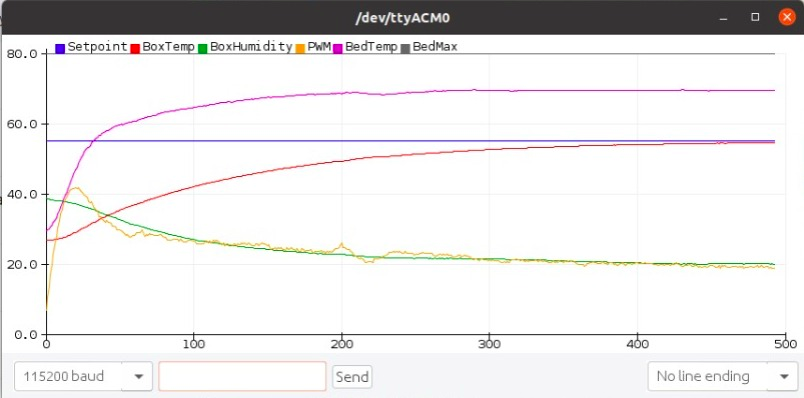
[picture p47: images/plot_55.png]


50 degree graph
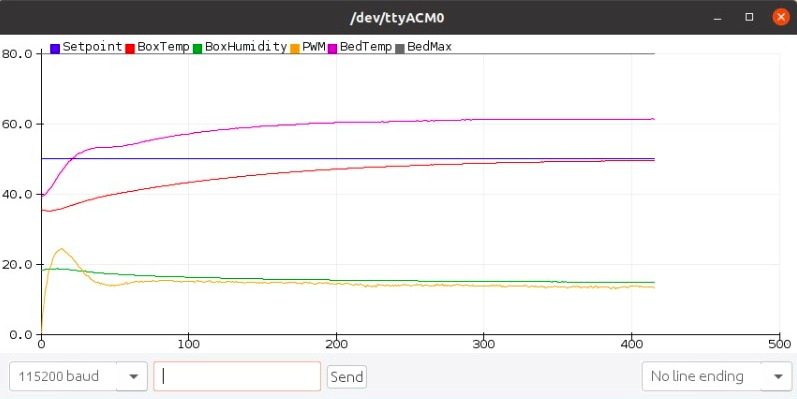
[picture p48: images/plot_50.png]


45 degree graph
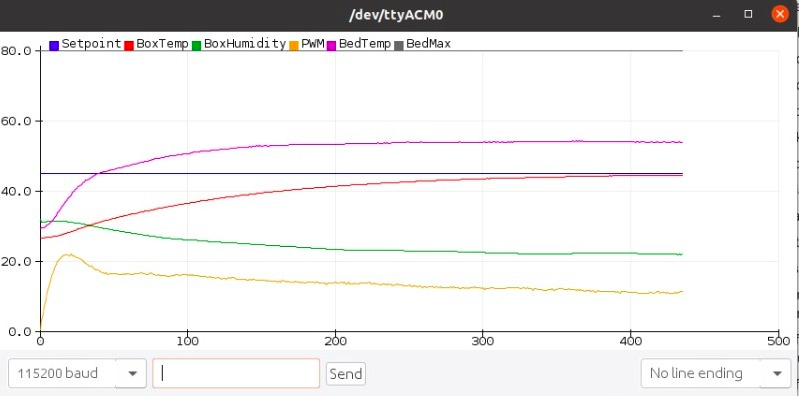
[picture p49: images/plot_45.png]


40 degree graph
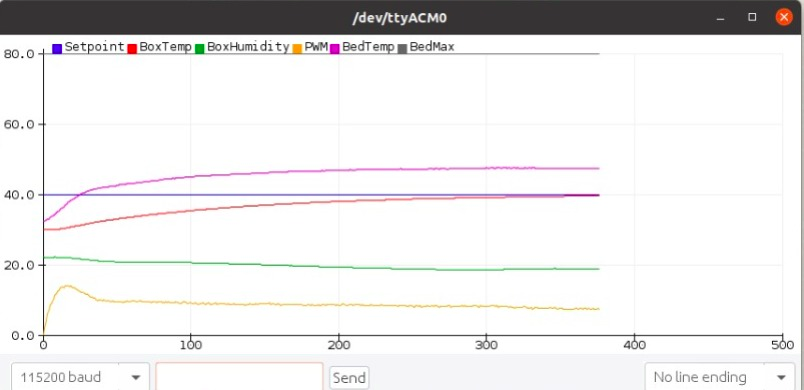
[picture p50: images/plot_40.png]


3D Printed Parts
----------------
Most of the pieces that make up the equipment are manufactured by the FDM method of 3D printing. Because the equipment can reach 60° Celcius, the box is printed in petg that resists between 5 and 10 degrees more than PLA; and the rollers, having to support the weight of the filament spool, use ABS.

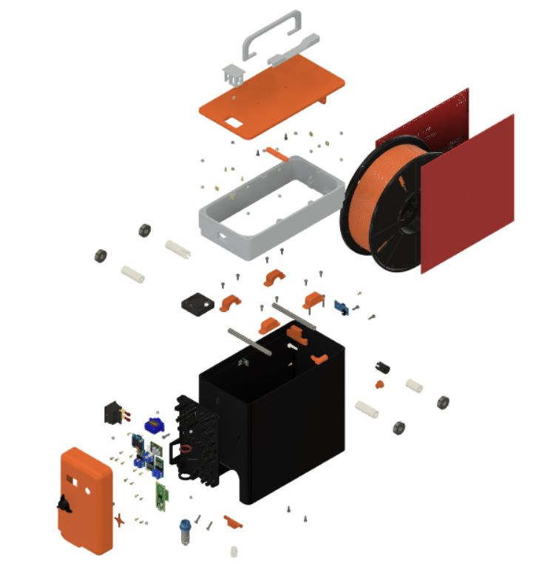
[picture p51: images/explode_view.png]


The lid that contains the vent valve and the bottle for the silica gel are printed in PLA and the fixing magnets are glued with cyanoacrylate to resist deformation due to the plastic's temperature.

The male pneumatic connector can be rotated 180 degrees so that the outlet is horizontal or vertical.

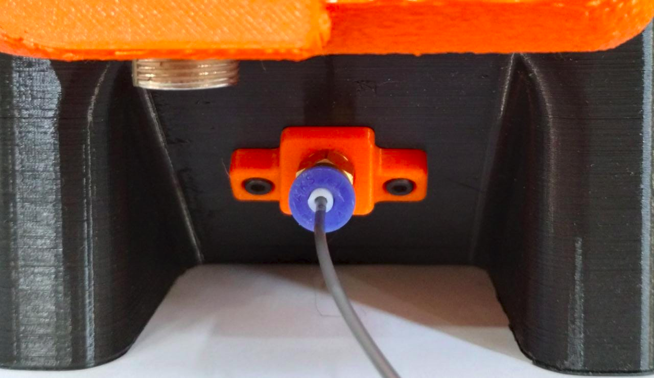
[picture p52: images/pneumatic_connector.png]


Click on the link to have a [3D view](https://myhub.autodesk360.com/ue2d9d88e/g/shares/SH35dfcQT936092f0e437288384b4c88dbbf) of the equipment model developed by Manuel Vela.

Bill of Materials
-----------------
The following is a complete list of materials including 3D printed parts, electronic components, fasteners, and miscellaneous.

<div class="ritz grid-container" dir="ltr"><table class="waffle no-grid" cellspacing="0" cellpadding="0">
<thead>
</thead>
<tbody><tr style="height: 20px"><th id="0R0" style="height: 20px;" class="row-headers-background"><div class="row-header-wrapper" style="line-height: 20px">1</div></th><td class="s0" dir="ltr">Image</td><td class="s0" dir="ltr">Description</td><td class="s0" dir="ltr">U/M</td><td class="s0" dir="ltr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
