jjsch-dev/filament_dryer_rp2040/images/drybox_serial_number_3_output_12V.jpeg

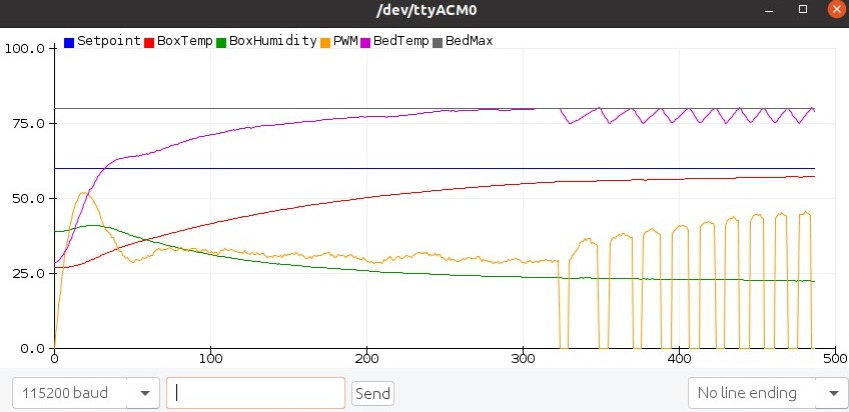
images/drybox_serial_number_3_output_12V.jpeg
