jjsch-dev/filament_dryer_rp2040/ParamStorage.h

/**
 * Stores PID constants and another params in EEPROM.  
 * As the RP2040 does not have EEPROM, picoarduino simulates it with a flash page.
 * 
 * MIT License
 * 
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
 * THE SOFTWARE IS PROVIDED "AS IS", WITHOUT WARRANTY OF ANY KIND, EXPRESS OR
 * IMPLIED, INCLUDING BUT NOT LIMITED TO THE WARRANTIES OF MERCHANTABILITY,
 * FITNESS FOR A PARTICULAR PURPOSE AND NONINFRINGEMENT. IN NO EVENT SHALL THE
 * AUTHORS OR COPYRIGHT HOLDERS BE LIABLE FOR ANY CLAIM, DAMAGES OR OTHER
 * LIABILITY, WHETHER IN AN ACTION OF CONTRACT, TORT OR OTHERWISE, ARISING FROM,
 * OUT OF OR IN CONNECTION WITH THE SOFTWARE OR THE USE OR OTHER DEALINGS IN THE
 * SOFTWARE.
 */ 
#pragma once

#define CONST_INITED          0x434f4e13 //53        // ASCII = CONS

#define ADDRESS_MAGIC_NUM       0
#define ADDRESS_KP              ADDRESS_MAGIC_NUM + sizeof(int)
#define ADDRESS_KI              ADDRESS_KP + sizeof(float)
#define ADDRESS_KD              ADDRESS_KI + sizeof(float) 
#define ADDRESS_THERMS          ADDRESS_KD + sizeof(float) 
#define ADDRESS_SETPOINT        ADDRESS_THERMS + sizeof(int)
#define ADDRESS_TIME            ADDRESS_SETPOINT + sizeof(int)
#define ADDRESS_ODOM_MODE       ADDRESS_TIME + sizeof(int)
#define ADDRESS_ODOM_MINUTES    ADDRESS_ODOM_MODE + sizeof(int)
#define ADDRESS_ODOM_TURNS      ADDRESS_ODOM_MINUTES + sizeof(int)
#define ADDRESS_ODOM_DIAMETER   ADDRESS_ODOM_TURNS + sizeof(int)
#define ADDRESS_MOISTURE_CLOSE  ADDRESS_ODOM_DIAMETER + sizeof(int)
#define ADDRESS_MOISTURE_OPEN   ADDRESS_MOISTURE_CLOSE + sizeof(int)
#define ADDRESS_CALIB_THERM_1   ADDRESS_MOISTURE_OPEN + sizeof(int)   
#define ADDRESS_CALIB_THERM_2   ADDRESS_CALIB_THERM_1 + sizeof(float) 

class ParamStorage  
{
public:
  ParamStorage(float kp, float ki, float kd, int therms, 
               int setpoint, int hours, int odom_mode, 
               int odom_minutes, int odom_turns, 
               int odom_diameter, int moisture_close_angle, 
               int moisture_open_angle, float calib_factor_therm_1, 
               float calib_factor_therm_2);
  ~ParamStorage() {};
  
  bool begin();
  float kp(void);
  float ki(void);
  float kd(void);
  int   therms(void);
  int   setpoint(void);
  int   get_time(void);
  int   odom_mode(void);
  int   odom_minutes(void);
  int   odom_turns(void);
  int   odom_diameter(void);
  int   moisture_close_angle(void);
  int   moisture_open_angle(void);
  float calib_factor_therm_1(void);
  float calib_factor_therm_2(void);
  
  float read_kp(void);
  float read_ki(void);
  float read_kd(void);
  int   read_therms(void);
  int   read_setpoint(void);
  int   read_time(void);
  int   read_odom_mode(void);
  int   read_odom_minutes(void);
  int   read_odom_turns(void);
  int   read_odom_diameter(void);
  int   read_moisture_close_angle(void);
  int   read_moisture_open_angle(void);
  float read_calib_factor_therm_1(void);
  float read_calib_factor_therm_2(void);
  
  void write_pid_const(float kp, float ki, float kd);
  void write_therms(int therms);
  void write_setpoint(int temp);
  void write_time(int hours);
  void write_odom_mode(int mode);
  void write_odom_minutes(int minutes);
  void write_odom_turns(int turns);
  void write_odom_diameter(int diam);
  void write_moisture_close_angle(int angle);
  void write_moisture_open_angle(int angle);
  void write_calib_factor_therm_1(float factor);
  void write_calib_factor_therm_2(float factor);
  
  void save(void);
  
private:
  int read_magic(void);
  void write_magic(int val);
  
  float _kp;  
  float _ki;
  float _kd; 
  int _therms;
  int _setpoint;
  int _time;
  int _odom_mode;
  int _odom_minutes;
  int _odom_turns;
  int _odom_diameter;
  int _moisture_close_angle;
  int _moisture_open_angle;
  float _calib_factor_therm_1; // Calibration factor for thermistor one
  float _calib_factor_therm_2; // Calibration factor for thermistor two
  
  int magic_number;
};
