jjsch-dev/filament_dryer_rp2040/HeaterController.h

/**
 * Controls the beds that are responsible for heating the filament box.  
 *
 * Encapsulates the PID and Tunner library.
 * 
 * MIT License
 * 
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
 * THE SOFTWARE IS PROVIDED "AS IS", WITHOUT WARRANTY OF ANY KIND, EXPRESS OR
 * IMPLIED, INCLUDING BUT NOT LIMITED TO THE WARRANTIES OF MERCHANTABILITY,
 * FITNESS FOR A PARTICULAR PURPOSE AND NONINFRINGEMENT. IN NO EVENT SHALL THE
 * AUTHORS OR COPYRIGHT HOLDERS BE LIABLE FOR ANY CLAIM, DAMAGES OR OTHER
 * LIABILITY, WHETHER IN AN ACTION OF CONTRACT, TORT OR OTHERWISE, ARISING FROM,
 * OUT OF OR IN CONNECTION WITH THE SOFTWARE OR THE USE OR OTHER DEALINGS IN THE
 * SOFTWARE.
 */ 
#pragma once

#include "Arduino.h"

#include <QuickPID.h>
#include <sTune.h>
#include <Servo.h>

#include "ParamStorage.h"

#define MODE_STOP               0
#define MODE_RUN_PID            1
#define MODE_RUN_TUNE           2

#define KP_DEFAULT              35.86 //10.16  
#define KI_DEFAULT              0.07  //0.04    
#define KD_DEFAULT              0.28  //0.11    

#define ST_DISABLED             0
#define ST_INITIALICE           1
#define ST_RUN_PID              2
#define ST_RUN_TUNE             3
#define ST_WAIT_BED_TEMP_DROP   4

#define HOT_BED_LEFT_PIN        10      // Hot left bed controller pin by PWM (490 Hz)
#define HOT_BED_RIGHT_PIN       11      // Hot right bed controller pin by PWM (490 Hz).
#define FAN_PIN                 12      // Fan controller pin by PWM (980 Hz).

#define OUT_ON                  255     // MAX PWM duty cicle  
#define OUT_OFF                 0       // MIN PWM duty cicle

#define MIN_SETPOINT            40      // Minimum Box temperature. 
#define MAX_SETPOINT            60      // Maximun Box temperature.
#define SETPOINT_DEFAULT        50

#define MOISTURE_SERVO_PIN      28      // Pin to control the humidity ventilation servo.
#define MOISTURE_DOOR_MIN       0       // This is a minimun degree angle of the servo.
#define MOISTURE_DOOR_MAX       180     // This is a maximun degree angle of the servo.
#define MOISTURE_CLOSE_DEFAULT  95      // The default position of the vent door for close.
#define MOISTURE_OPEN_DEFAULT   45      // The default position of the vent door for open.


class HeaterController 
{
public:
  HeaterController(int pwm_freq, int pwm_res, float max_bed_temp, ParamStorage& storage);
  ~HeaterController() {};

  bool begin(void);
  float update(float box_temp, float bed_temp);
  void inc_setpoint(int count);
  int get_setpoint(void);
  int get_mode(void);
  void set_mode(int mode);
  void start();
  void stop();
  int tuning_percentage(void );
  void set_tunings(void);
  bool setpoint_reached(void);
  void set_moisture_close_angle(int value); 
  void set_moisture_angle(bool state, int value);
   
private:
  QuickPID      pid;
  sTune         tuner; 
  Servo         moisture_servo;  
  ParamStorage& pstorage;
  
  int   _mode;
  int   pid_status;
  int   tune_status;
  int   pwm_frequency;
  int   pwm_resolution;
  float max_bed_temp;
  
  float pid_input;
  float pid_output;
  float pid_setpoint;
  
private:
  uint32_t  tune_settle_time_sec;
  uint32_t  tune_test_time_sec;     // runPid interval = testTimeSec / samples
  uint16_t  tune_samples;
  float     tune_input_span;
  float     tune_output_span;
  float     tune_output_start;
  float     tune_output_step;
  float     tune_temp_limit;
  uint8_t   tune_debounce;
  uint16_t  tune_samples_count;
  
  float     tune_input;
  float     tune_output;
  float     tune_setpoint;

  int       pid_sample_timeout;
  
private:
  float pid_controller(float box_temp, float bed_temp);
  float tune_controller(float input, float bed_temp);
  void  pwm(int output);
  void  fan_cooler(int output);
  bool moisture_door(bool state);
  bool moisture_move(int angle);
};
