jjsch-dev/filament_dryer_rp2040/TempSensors.cpp

/**
 * Encapsulates the temperature and humidity sensors.  
 * One read at a time is performed to optimize the time the CPU 
 * hangs while performing the read.
 * 
 * MIT License
 * 
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
 * THE SOFTWARE IS PROVIDED "AS IS", WITHOUT WARRANTY OF ANY KIND, EXPRESS OR
 * IMPLIED, INCLUDING BUT NOT LIMITED TO THE WARRANTIES OF MERCHANTABILITY,
 * FITNESS FOR A PARTICULAR PURPOSE AND NONINFRINGEMENT. IN NO EVENT SHALL THE
 * AUTHORS OR COPYRIGHT HOLDERS BE LIABLE FOR ANY CLAIM, DAMAGES OR OTHER
 * LIABILITY, WHETHER IN AN ACTION OF CONTRACT, TORT OR OTHERWISE, ARISING FROM,
 * OUT OF OR IN CONNECTION WITH THE SOFTWARE OR THE USE OR OTHER DEALINGS IN THE
 * SOFTWARE.
 */ 
#include "TempSensors.h"

TempSensors::TempSensors(unsigned long timeout_ms, ParamStorage& storage) :
             pstorage(storage), 
             sht(HTU21D_ADDR, SHT_WIRE),
             bed_left_therm(BED_LEFT_THERM_PIN, 0),
             bed_right_therm(BED_RIGHT_THERM_PIN, 0) {
    
  sample_timeout = timeout_ms;
  last_sample = millis() + sample_timeout + 1;
  
  box_temp = 0;  
  humidity = 0;
  bed_left_temp = 0;
  bed_right_temp = 0; 
  sensor_id = 0;

  calib_factor = 0.934250252;
}
 
bool TempSensors::begin() {
  SHT_WIRE.setSDA(SHT_SDA_PIN);
  SHT_WIRE.setSCL(SHT_SCL_PIN);
  
  sht.begin(); // include "Wire.begin();" that start the i²c communication
  
  /* 
   * The resolution of the pico nano processor ADC is fixed at 12 bits (4096), 
   * but the tables for calculating temperatures are made for 10-bit steps (1024), 
   * so you need to set the resolution to 10 bits.
   */
  analogReadResolution(10);
  
  /* 
   * Raspberry Pi Pico 
   * Driving high the SMPS mode pin (GPIO23), to force the power supply into PWM mode, 
   * can greatly reduce the inherent ripple of the SMPS at light load, and therefore the 
   * ripple on the ADC supply. 
   */
  pinMode(SMPS_MODE_PIN, OUTPUT);
  digitalWrite(SMPS_MODE_PIN, HIGH);

  return true;
}

bool TempSensors::update() {
unsigned long now = millis();    
  /*
   * To prevent the reading of the humidity and temperature sensor (60 mS delay) 
   * from interfering with the debounce timer of the encoder button (10 mS), 
   * one is performed every 100 mS.
   */
  if (now > (last_sample + sample_timeout) ) {
    last_sample = now;
  
    /*
     * Alternate the bed temperature reading to improve the stability.
     */
    switch(sensor_id++) {
      case 0:
        if (sht.measure()) {
          box_temp = sht.getTemperature();
          humidity = sht.getHumidity();
        }
      break;
      
      case 1:
        bed_left_temp = bed_left_therm.analog2temp() * pstorage.calib_factor_therm_1(); 
      break;
      
      case 2:
        bed_right_temp = bed_right_therm.analog2temp() * pstorage.calib_factor_therm_2(); 
      break;
      
      default:
        sensor_id = 0;
    }

    if (sensor_id > pstorage.therms()) {
      sensor_id = 0;  
    } 
    
    return true;
  }
  
  return false;   
}

float TempSensors::box_celcius(void) {
  return box_temp;  
}

float TempSensors::box_humidity(void) {
  return humidity;
}

float TempSensors::bed_left_celcius(void) {
  return (pstorage.therms() > 0) ? bed_left_temp : 0;
}

float TempSensors::bed_right_celcius(void) {
  return (pstorage.therms() == 2) ? bed_right_temp : 0; 
}

void TempSensors::set_therms(int count) {
  int new_val = pstorage.therms() + count;

  if ((new_val >= 0) && (new_val <= THERMS_DEFAULT) ) {
    pstorage.write_therms(new_val);
  }
}

int TempSensors::get_therms(void) {
  return pstorage.therms();  
}

bool TempSensors::calib_therms(void) {
  
  if (sht.measure()) {
    box_temp = sht.getTemperature();
    humidity = sht.getHumidity();

    bed_left_temp = bed_left_therm.analog2temp();
    bed_right_temp = bed_right_therm.analog2temp();
    
    pstorage.write_calib_factor_therm_1(box_temp / bed_left_temp); 
    pstorage.write_calib_factor_therm_2(box_temp / bed_right_temp); 
        
    bed_left_temp *= pstorage.calib_factor_therm_1(); 
    bed_right_temp *= pstorage.calib_factor_therm_2(); 

    return true;
  }

  return false;
}
