jjsch-dev/filament_dryer_rp2040/(commit log)

2022-11-02 Heater Class
    Added a heater class to encapsulate the behavior of the PID and TUNE controller.
2022-11-02 fix tune output and percentage
    The heater class has begun to be validated, tests with the box are still pending, but for this it is necessary to install the sensors and the actuator.
    [HeaterController.cpp, HeaterController.h]
2022-11-03 Fixes for the first test with Raspberry PI Pico
    The tuner and heater mode were adjusted, the detection of a USB serial port connection was added, the recording module of the constants in the eeprom was tested, the presentation of information on the display was adjusted.
    [HeaterController.cpp, HeaterController.h, PIDConst.h, filament_dryer_rp2040.ino]
2022-11-03 Set frequency of PWM
    Set a similar frequency of the Arduino Nano PWM (490Hz)
    Improves plotting of PID and Tuner variables.
2022-11-03 Added PWM resolution setting
    NOTE: for now the resolution in 8 bits does not work with frequencies lower than 1Khz with the porting for Arduino of Raspberry PI Pico. See issue: https://github.com/earlephilhower/arduino-pico/issues/955
    [HeaterController.cpp, HeaterController.h, filament_dryer_rp2040.ino]
2022-11-04 Added execution timer
    The execution timer stops the operation when the time in hours expires.
    Adjusted the user information screen.
2022-11-04 Improved console output
    Added Bed Max Limit and Bed Temperature fields.
    The presentation information is sent only once, this is so that the plotter does not show invalid fields.
2022-11-07 Set the PWM frequency to 500 Hz and the range to 255
    With the repair of the number #955 issue of arduinopico you can use frequencies lower than 1Khz to reduce the effect of inductance, and use a range of 255.
    [HeaterController.cpp, filament_dryer_rp2040.ino]
2022-11-07 Moisture field was added for pid chart.
2022-11-08 the temperature of the beds was unified
    For the calculations, the max function is used with the temperatures of the two beds.
2022-11-08 change in temperature selector
    The temperature can be regulated between 40 and 60 degrees. 0 = disabled
2022-11-08 update plot graph
    sends a sample every 5 seconds so that it can be displayed in 500 samples.
2022-11-08 uodate plot graph
    In tuned mode it sends a sample every second.
2022-11-09 plot delay
    The delay for ploting in PID mode changed to 6 seconds so that the 100-by-100 time axis of the graph coincides with 10 minutes.
2022-11-09 configuration menu modification
    Now, to exit the settings, you need to select the exit menu and press click. To modify a parameter, you need to select it with the encoder and click to enter edit mode, then it is possible to use the encoder to decrease or increase it.
2022-11-10 fix menu variables, update comments
    By mistake, the variable that calculates the number of menu items was declared as char instead of uint8_t.
    [filament_dryer_rp2040.ino]
2022-11-11 Added UI class
    The class encapsulates the behavior of the OLED display and the rotary encoder. It also controls a user-configurable menu list that allows output, editing, and information items.
2022-11-13 Added thermistor settings menu
    It is possible to select two thermistors to control the maximum temperature of the heater, one or disable this function.
    Modified pid const class so that in addition to PID constants, thermistors can be saved.
2022-11-13 The parameter storage class is passed as a reference in the heater and sensor constructor.
    This avoids the callback function in the tuner and eliminates duplicate variables for configuration parameters.
    [HeaterController.cpp, HeaterController.h, TempSensors.cpp, TempSensors.h, filament_dryer_rp2040.ino]
2022-11-13 fix parameter store write functions
    Since the eeprom is a simulated module of the RP2040 on Arduino, the library's put functions only write to the RAM buffer allocated with begin. And when the commit function is called, the flash is updated by stopping the IRQs.
    [ParamStorage.cpp, menu_config.h]
2022-11-13 error in the last commit
    the size of the menu list was indicated by sizeof instead of size_t.
    [UserInterface.cpp, UserInterface.h]
2022-11-14 factory reset and firmware test
    Added factory reset menu, to load default values for PID constants and number of thermistors.
    [HeaterController.cpp, HeaterController.h, ParamStorage.cpp, TempSensors.cpp, filament_dryer_rp2040.ino, menu_config.h]
2022-11-14 add setpoint and time to eeprom
    Now the setpoint and the duration in hours are stored in the eeprom. The heater start and stop mechanism has been modified to be consistent with the new menu.
2022-11-14 fix heater class
2022-11-14 heater controller
    Added bed overheat protection when PID is tuned.
    [HeaterController.cpp, HeaterController.h]
2022-11-15 sample time PID - first binary file
    The sample time of the PID has to match that of the tuner, and uses uS as the unit.
    After tests at 50, 55 and 60 degrees for one hour, real tests are carried out.
2022-11-16 readme temperature
2022-11-22 wire colors
2022-11-22 odometer data pin is now GPIO14
2022-11-23 Added turn off/on PID from odometer
    The odomotro's three configuration modes allow power on/off or both.
    The odometer shutdown function is activated when the PID reaches the set temperature (+- 0.5 C).
    The number of laps of the odometer is stored in the flash every 10 minutes to prevent deterioration.
    You can configure the number of minutes that the system has to be inactive to execute the shutdown function.
    The lap counter can be reset from the menu by turning the encoder to the left.
    [HeaterController.cpp, HeaterController.h, Odometer.cpp, Odometer.h, ParamStorage.cpp, ParamStorage.h, filament_dryer_rp2040.ino, menu_config.h]
2022-11-23 fix odometer class, add comments
    [Odometer.cpp, Odometer.h, ParamStorage.cpp, filament_dryer_rp2040.ino]
2022-11-23 reset odometer
    Resets the shutdown timer to prevent the stop callback from continuously firing while the desired temperature is reached.
    [filament_dryer_rp2040.ino]
2022-12-09 add rocket switch
2022-12-12 fix the 24 hour limit
    When more than 24 hours was set the presentation did not show more than 24 hours, it was solved using gmtime and adding the days of the year to the hours field.
    [RunTimer.cpp]
2022-12-12 fix encoder pins
2022-12-13 user interfase timeouts
    If it is in setup mode, and user idle time expired, it exits the menu and in the while refreshes the menu data every second (useful for bed temperature and odometer).
2022-12-13 fixes the positions of the pid constants on the screen
    Constants with 3 digits override display positions.
    [menu_config.h]
2022-12-20 Schematics with servo control
2022-12-22 Add servo for moisture vent
    To vent moisture when the heater is running, a servo was added that moves a door that allows moisture to escape outside.
2022-12-22 PID default constants
2023-01-04 moisture idle angle
    Added a settings menu to adjust the home position of the servo that controls the moisture vent gate.
2023-01-05 moisture servo
    The setting is changed to set the open and closed position of the gate to vent moisture.
2023-01-06 default values for attach in moisture servo
    The defaults in the Servo library here are a little conservative here to avoid damage in the case of over-driving. The pulse widths individual servos, especially the no-name or clones, need are sometimes variable.
    You can set the min and max servo pulse width in the attach command. See https://www.arduino.cc/reference/en/libraries/servo/attach/
    [HeaterController.cpp, HeaterController.h]
2023-01-06 moisture servo
    Added a function to encapsulate the angular movement of the servo.
2023-01-09 odometer - start/stop
    Since version 1.0.3, when the reel diameter parameter was added to count the turns using the odometer pulses, the get_turns function was mistakenly used in the detection of automatic turns on and off.
    [HeaterController.cpp, HeaterController.h, Odometer.cpp]
2023-01-09 odometer start
    Changed odometer auto-ignition logic to prevent box bumps from triggering it. Ten detections in a 10 second window are now required to validate the feature.
    [Odometer.cpp, Odometer.h]
2023-01-10 odometer start
    Changed odometer auto-on logic to prevent box bumps from activating it. Ten detections every 100 mS are now required to turn it on.
    [Odometer.cpp, Odometer.h, filament_dryer_rp2040.ino]
2023-01-12 add power supply in readme
2023-01-13 add thermistor in readme
2023-01-13 add power_supply_5v in readme
2023-01-13 add quote of adj 5.5V in readme
2023-01-13 add power switch in readme
2023-01-13 change power_switch picture
2023-01-13 add pneumatic_connector in readme
2023-01-13 add links for mosfet and cooler in readme
2023-01-17 add install arm in readme
2023-01-18 add assembly video in readme
2023-01-18 assembly video 8mega in readme
2023-01-20 add bom in readme
2023-01-20 fix bom list in readme
2023-03-02 calibrate thermistors
    I used the temperature of the SHT21 sensor to calibrate the heater’s thermistors. This improves the accuracy and performance of the system.
2023-03-03 add calibration menu in readme
2023-03-03 Resetting heater power when temperature exceeds threshold
    Reset the power of the heater from 0 so that the PID rebuilds the curve when the heater temperature exceeds 80 degrees. This event of exceeding 80 degrees of the heater happens when the lid is removed or the PID is poorly tuned.
    [HeaterController.cpp, filament_dryer_rp2040.ino]
2023-03-07 Add DooLidSensor Class
    This class controls a mechanical door open sensor that when it detects that it is open displays a message on the display and turns off the heater.
2023-03-07 update schematics with lid sensor
2023-03-16 odometer start function change
    Waits for a single turn to elapse and that it is within the time window (50-500 mS) to be considered valid. If it detects two or more turns, it discards them. Prevents bumps in the box from generating a false start. Waits 5 pulses to turn on the equipment.
    [Odometer.cpp, Odometer.h, filament_dryer_rp2040.ino]
2023-03-17 lid switch
    Now the odometer activates the heater when the door is closed.
2023-03-20 Fix odomoter module
    The pulse-detecting ISR was improved to filter out optical sensor transitions that generated micropulses of 400 uS duration.
    [Odometer.cpp, Odometer.h, filament_dryer_rp2040.ino]
2023-03-28 odometer
    Resets the automatic start of the heater, in case the odometer has already detected an event, which would generate a false start.
    [Odometer.cpp, filament_dryer_rp2040.ino]
2023-05-31 update readme with printable repository
