jjsch-dev/filament_dryer_rp2040/(notices)

Notices in the files:
TempSensors.cpp:
Copyright (c) 2022 Juan Schiavoni
